mikefsq/scope_hub/mech/bottom_cover.step

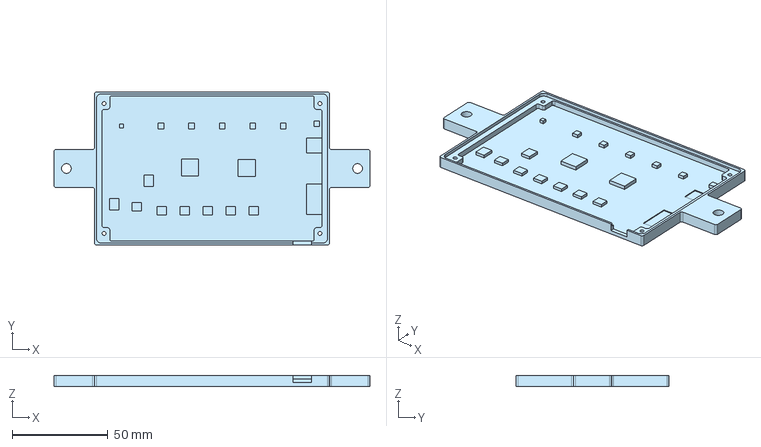
[picture p2: CAD file, 2026-11-07]
mech/bottom_cover.step
165.4 x 80.0 x 5.50 mm
