mikefsq/scope_hub/mech/top_cover.step

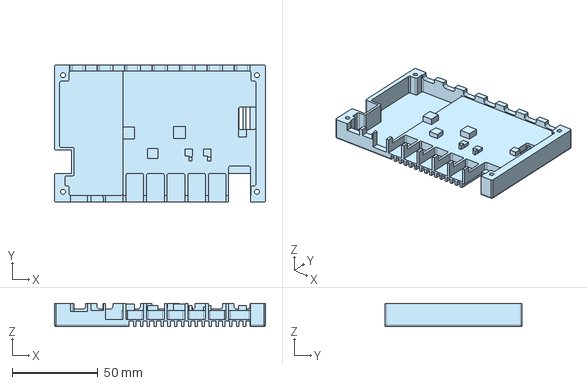
[picture p3: CAD file, 2026-11-01]
mech/top_cover.step
123.0 x 80.0 x 13.5 mm
