mikefsq/scope_hub/mech/ap_los_spacer_11mm.step

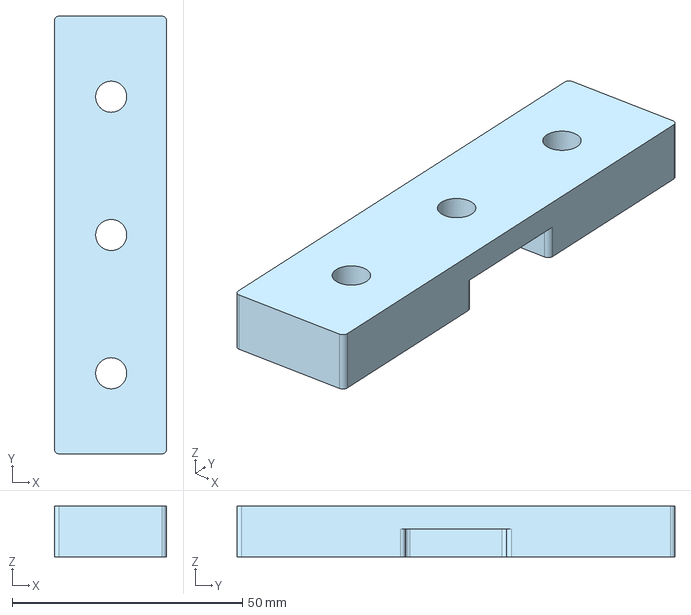
[picture p4: CAD file, 2026-11-01]
mech/ap_los_spacer_11mm.step
24.3 x 95.0 x 11.0 mm
