mikefsq/scope_hub/mech/primaluce_los_spacer_11mm.step

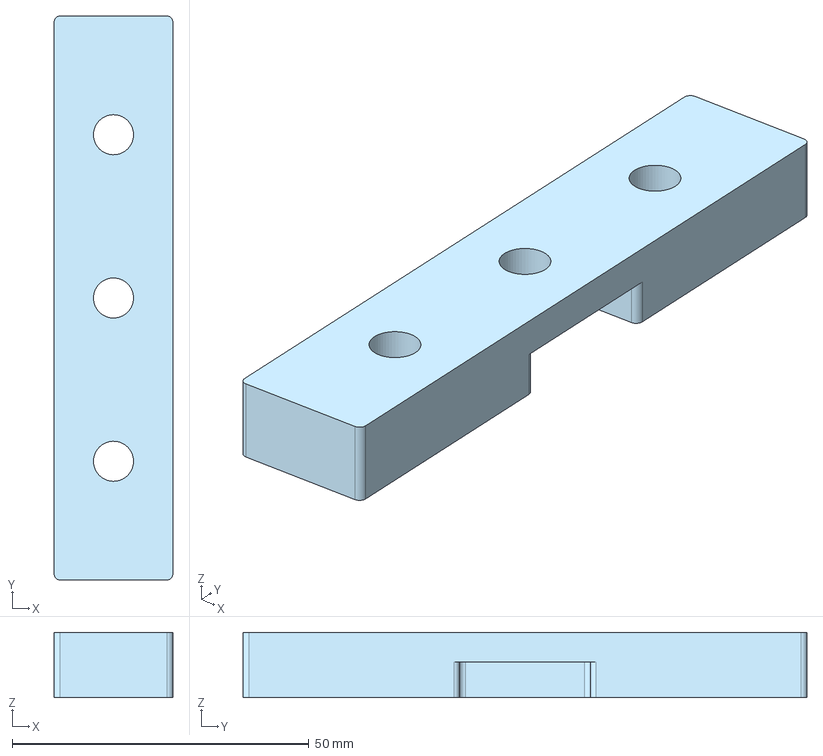
[picture p5: CAD file, 2026-11-01]
mech/primaluce_los_spacer_11mm.step
20.0 x 95.0 x 11.0 mm
