mikefsq/scope_hub/pcb/scope_hub.kicad_pcb

## KiCad design pcb/scope_hub.kicad_pcb (2026-10-31)

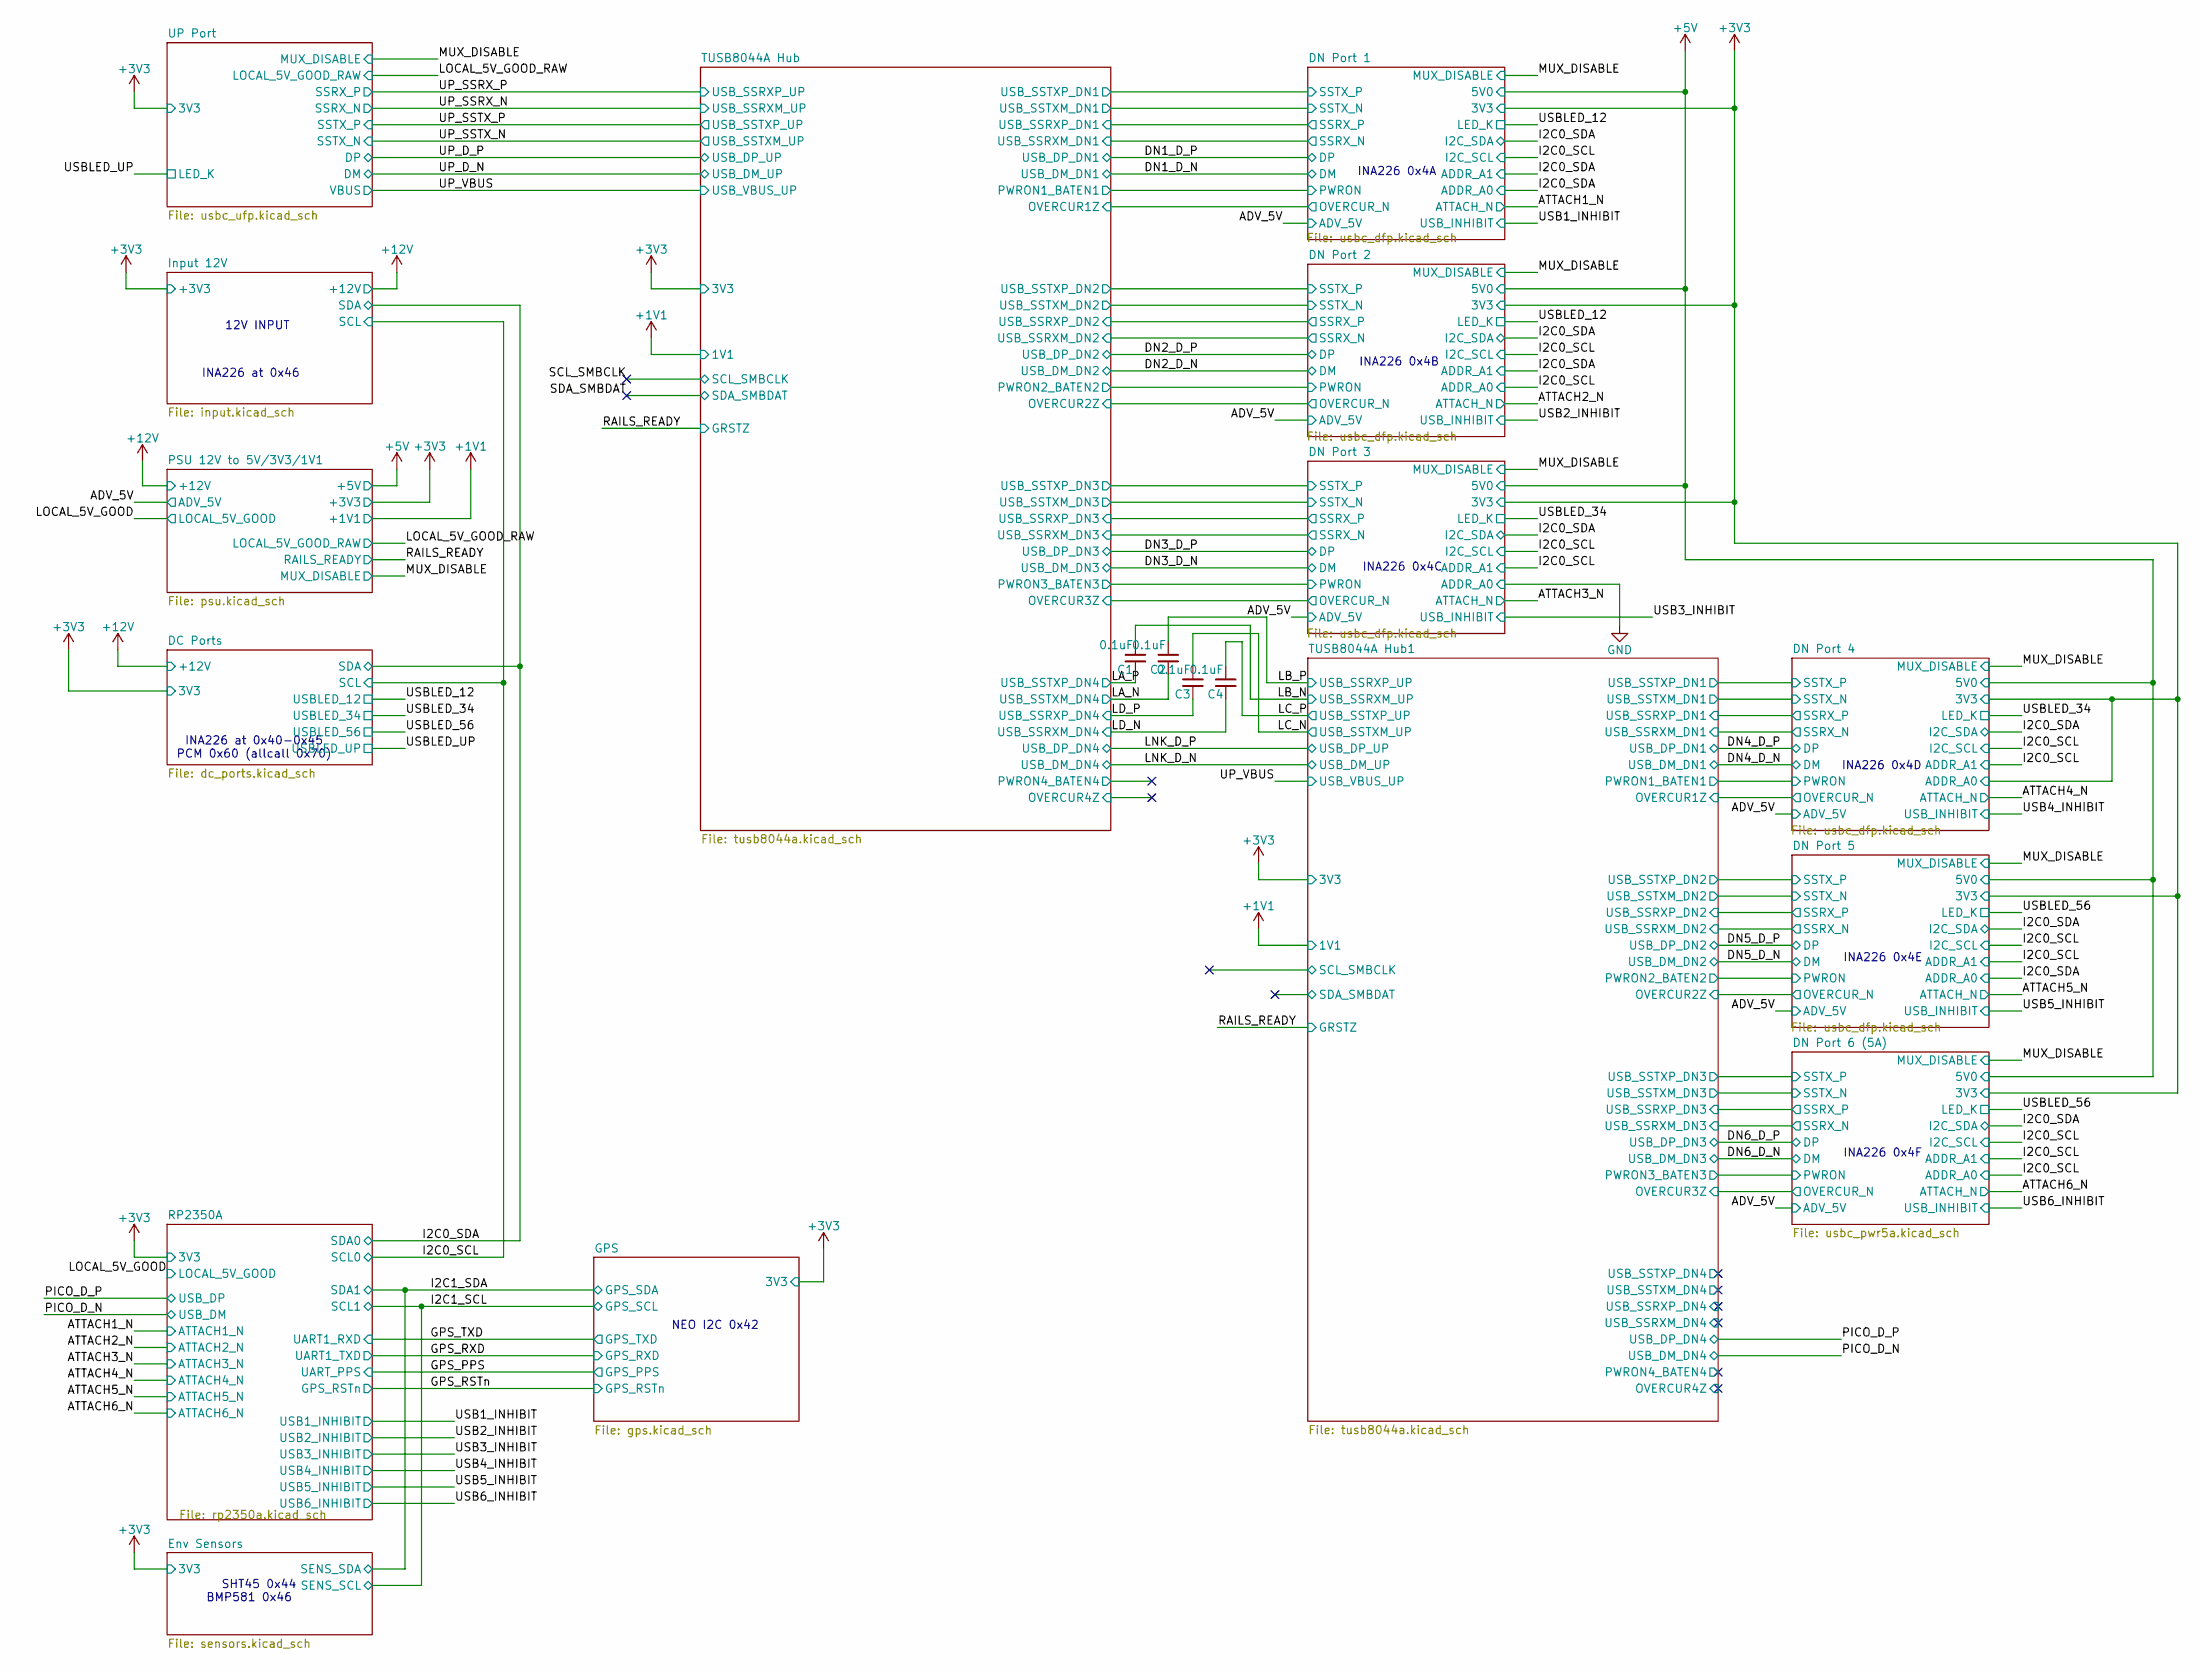
[picture p6: schematic scope_hub.kicad_sch]

Parts:
C1, C2, C3, C4: 0.1uF; C_0402_1005Metric; LCSC C1525

Connections:
/LA_N: C2.1; also elsewhere on the board
/LA_P: C1.1; also elsewhere on the board
/LB_N: C1.2; also elsewhere on the board
/LB_P: C2.2; also elsewhere on the board
/LC_N: C3.2; also elsewhere on the board
/LC_P: C4.2; also elsewhere on the board
/LD_N: C4.1; also elsewhere on the board
/LD_P: C3.1; also elsewhere on the board

Notes on the sheet:
12V INPUT
INA226 0x4C
INA226 at 0x40-0x45 PCM 0x60 (allcall 0x70)
INA226 0x4E
INA226 0x4B
INA226 0x4F
INA226 at 0x46
SHT45 0x44
BMP581 0x46
NEO I2C 0x42
INA226 0x4D
INA226 0x4A

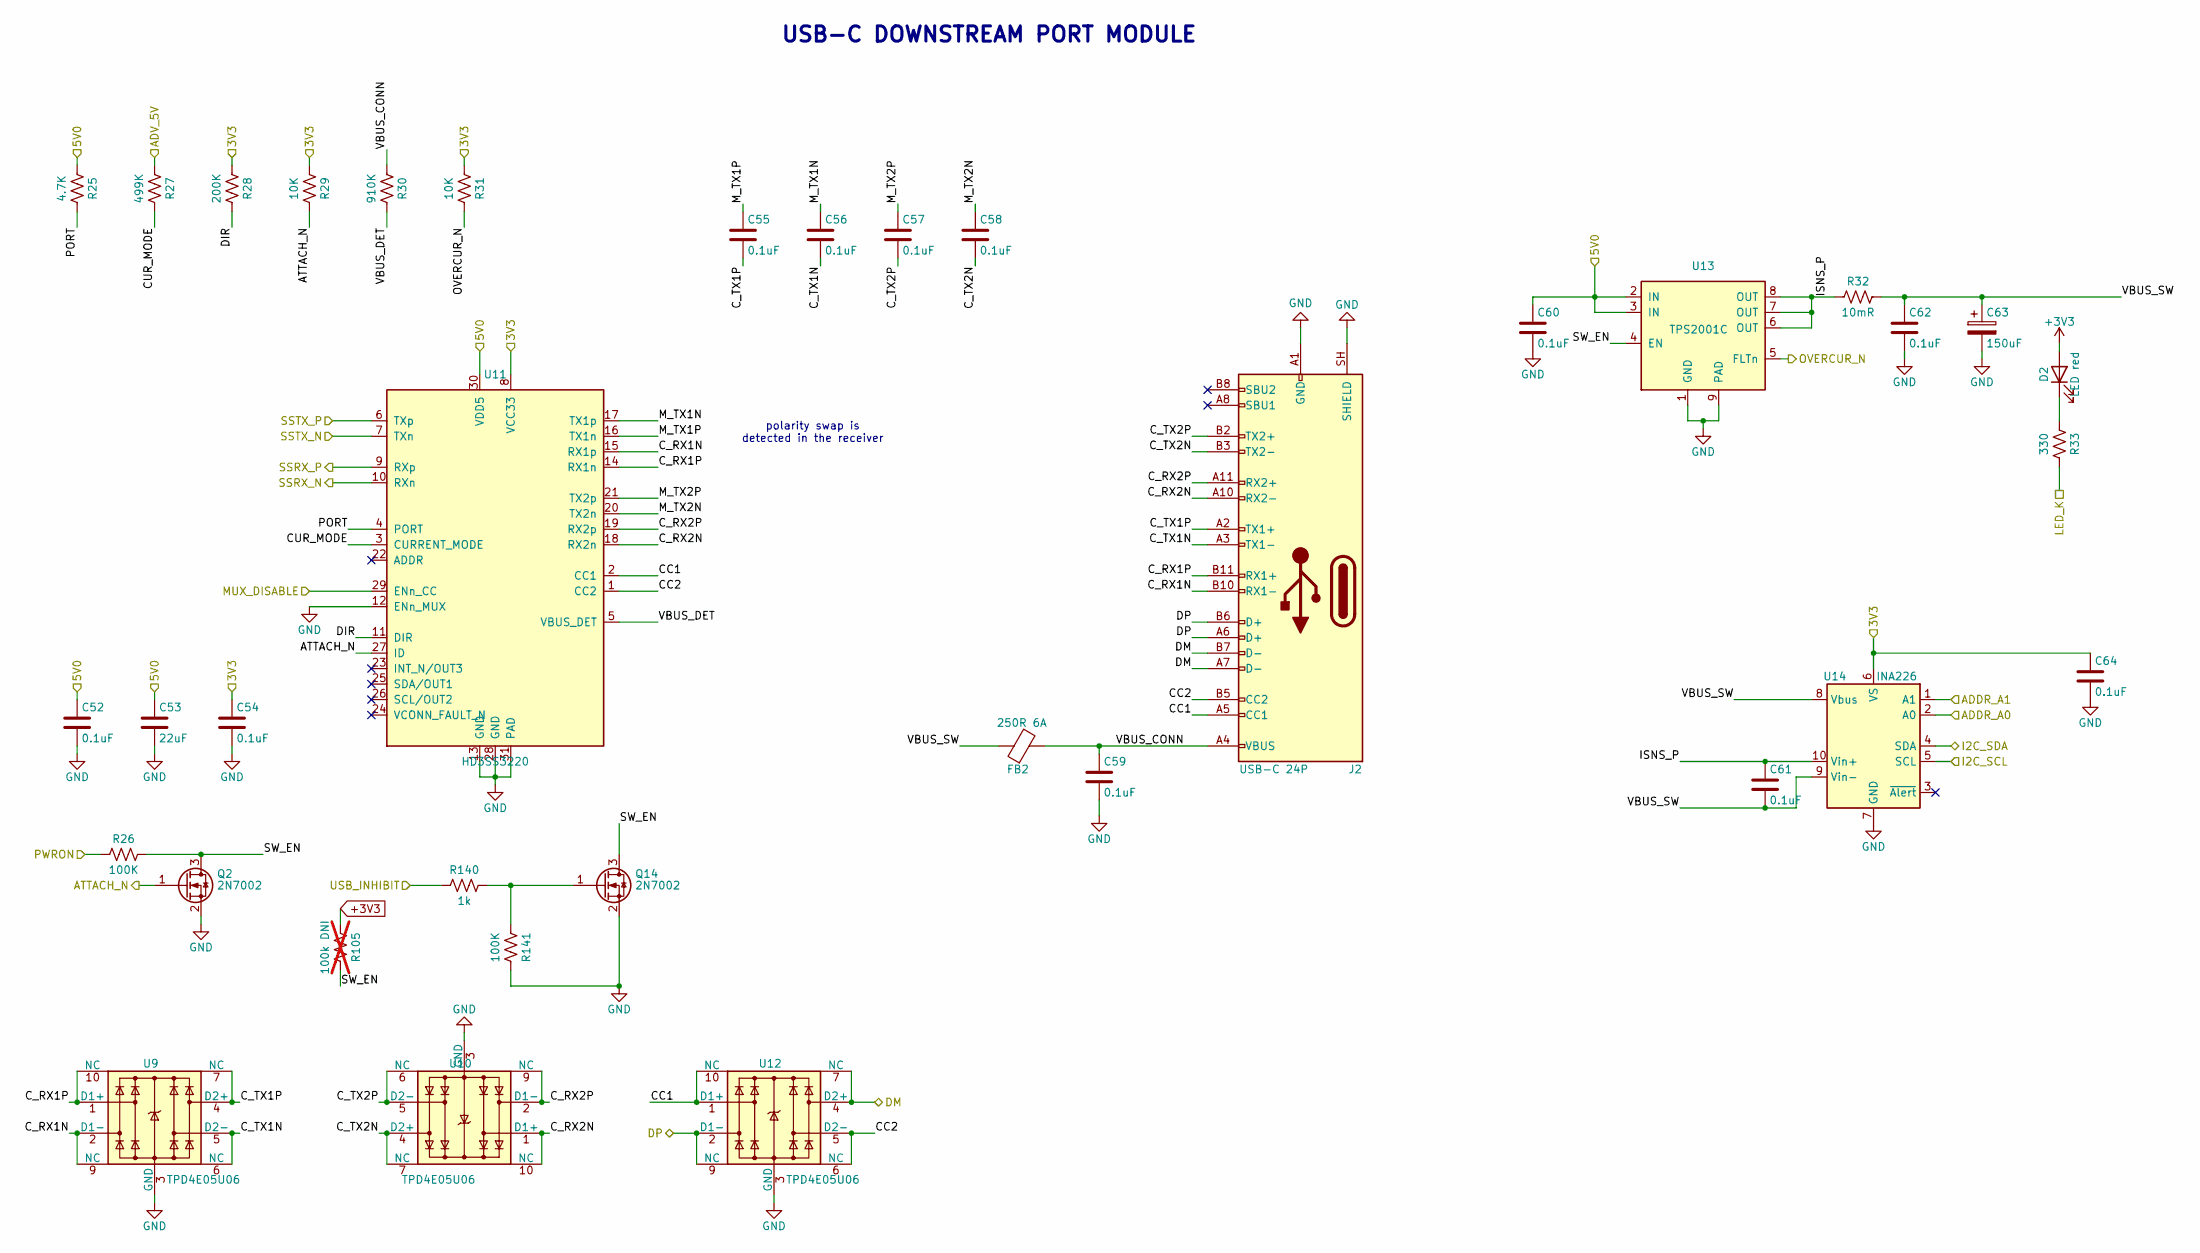
[picture p7: schematic usbc_dfp.kicad_sch]

Parts:
C52, C54, C55, C56, C57, C58, C59, C60, C61, C62, C64: 0.1uF; C_0402_1005Metric; LCSC C1525
C53: 22uF; C_0805_2012Metric; LCSC C45783
C63: 150uF; CP_EIA-3528-21_Kemet-B; LCSC C212682
D2: LED red; LED_0805_2012Metric; LCSC C84256
FB2: 250R 6A; FB_201210_PROD; MPN PSBHAA201210H-251T060; LCSC C48543401
J2: USB-C 24P; USB_C_Receptacle_Molex_105450-0101; MPN 105450-0101; LCSC C134092
Q2: 2N7002; SOT-23; LCSC C8545
Q14: 2N7002; SOT-23; MPN 2N7002; LCSC C8545
R25: 4.7K; R_0402_1005Metric; LCSC C25900
R26: 100K; R_0402_1005Metric; LCSC C25741
R27: 499K; R_0402_1005Metric; LCSC C25793
R28: 200K; R_0402_1005Metric; LCSC C25764
R29, R31: 10K; R_0402_1005Metric; LCSC C25744
R30: 910K; R_0402_1005Metric; LCSC C25800
R32: 10mR; R_1206_3216Metric; LCSC C105362
R33: 330; R_0402_1005Metric; LCSC C25104
R105: 100k DNI; R_0402_1005Metric; not fitted
R140: 1k; R_0402_1005Metric; MPN 0402WGF1001TCE; LCSC C11702
R141: 100K; R_0402_1005Metric; MPN 0402WGF1003TCE; LCSC C25741
U9, U10, U12: TPD4E05U06; USON-10_2.5x1.0mm_P0.5mm; LCSC C138714
U11: HD3SS3220; Texas_RNH0030A_WQFN-30-1EP_2.5x4.5mm_P0.4mm_EP1.2x3.2mm; LCSC C165155
U13: TPS2001C; MSOP-8-1EP_3x3mm_P0.65mm_EP1.68x1.88mm; LCSC C473349
U14: INA226; TSSOP-10_3x3mm_P0.5mm; LCSC C49851

Connections:
+3V3: C54.1, C64.1, D2.2 (A), R28.1, R29.1, R31.1, R105.1, U11.8 (VCC33), U14.6 (VS); also elsewhere on the board
+5V: C52.1, C53.1, C60.1, R25.1, U11.30 (VDD5), U13.2 (IN), U13.3 (IN); also elsewhere on the board
/ADV_5V: R27.1; also elsewhere on the board
/ATTACH2_N: Q2.1 (G), R29.2, U11.27 (ID); also elsewhere on the board
/DN2_D_N: J2.A7 (D-), J2.B7 (D-), U12.4 (D2+), U12.7 (NC); also elsewhere on the board
/DN2_D_P: J2.A6 (D+), J2.B6 (D+), U12.2 (D1-), U12.9 (NC); also elsewhere on the board
/DN Port 2/CC1: J2.A5 (CC1), U11.2 (CC1), U12.1 (D1+), U12.10 (NC)
/DN Port 2/CC2: J2.B5 (CC2), U11.1 (CC2), U12.5 (D2-), U12.6 (NC)
/DN Port 2/CUR_MODE: R27.2, U11.3 (CURRENT_MODE)
/DN Port 2/C_RX1N: J2.B10 (RX1-), U9.2 (D1-), U9.9 (NC), U11.15 (RX1p)
/DN Port 2/C_RX1P: J2.B11 (RX1+), U9.1 (D1+), U9.10 (NC), U11.14 (RX1n)
/DN Port 2/C_RX2N: J2.A10 (RX2-), U10.1 (D1+), U10.10 (NC), U11.18 (RX2n)
/DN Port 2/C_RX2P: J2.A11 (RX2+), U10.2 (D1-), U10.9 (NC), U11.19 (RX2p)
/DN Port 2/C_TX1N: C56.2, J2.A3 (TX1-), U9.5 (D2-), U9.6 (NC)
/DN Port 2/C_TX1P: C55.2, J2.A2 (TX1+), U9.4 (D2+), U9.7 (NC)
/DN Port 2/C_TX2N: C58.2, J2.B3 (TX2-), U10.4 (D2+), U10.7 (NC)
/DN Port 2/C_TX2P: C57.2, J2.B2 (TX2+), U10.5 (D2-), U10.6 (NC)
/DN Port 2/DIR: R28.2, U11.11 (DIR)
/DN Port 2/ISNS_P: C61.1, R32.1, U13.6 (OUT), U13.7 (OUT), U13.8 (OUT), U14.10 (Vin+)
/DN Port 2/M_TX1N: C56.1, U11.17 (TX1p)
/DN Port 2/M_TX1P: C55.1, U11.16 (TX1n)
/DN Port 2/M_TX2N: C58.1, U11.20 (TX2n)
/DN Port 2/M_TX2P: C57.1, U11.21 (TX2p)
/DN Port 2/OVERCUR_N: R31.2, U13.5 (FLTn); also elsewhere on the board
/DN Port 2/PORT: R25.2, U11.4 (PORT)
/DN Port 2/SSRX_N: U11.10 (RXn); also elsewhere on the board
/DN Port 2/SSRX_P: U11.9 (RXp); also elsewhere on the board
/DN Port 2/SSTX_N: U11.7 (TXn); also elsewhere on the board
/DN Port 2/SSTX_P: U11.6 (TXp); also elsewhere on the board
/DN Port 2/SW_EN: Q2.3 (D), Q14.3 (D), R26.2, R105.2, U13.4 (EN)
/DN Port 2/VBUS_CONN: C59.1, FB2.2, J2.A4 (VBUS), J2.A9 (VBUS), J2.B4 (VBUS), J2.B9 (VBUS), R30.1
/DN Port 2/VBUS_DET: R30.2, U11.5 (VBUS_DET)
/DN Port 2/VBUS_SW: C61.2, C62.1, C63.1, FB2.1, R32.2, U14.8 (Vbus), U14.9 (Vin-)
/I2C0_SCL: U14.2 (A0), U14.5 (SCL); also elsewhere on the board
/I2C0_SDA: U14.1 (A1), U14.4 (SDA); also elsewhere on the board
/MUX_DISABLE: U11.29 (ENn_CC); also elsewhere on the board
/TUSB8044A Hub/PWRON2_BATEN2: R26.1; also elsewhere on the board
/USB2_INHIBIT: R140.1; also elsewhere on the board
/USBLED_12: R33.2; also elsewhere on the board
GND: C52.2, C53.2, C54.2, C59.2, C60.2, C62.2, C63.2, C64.2, J2.A1 (GND), J2.A12 (GND), J2.B1 (GND), J2.B12 (GND), J2.SH (SHIELD), Q2.2 (S), Q14.2 (S), R141.2, U9.3 (GND), U9.8 (GND), U10.3 (GND), U10.8 (GND), U11.12 (ENn_MUX), U11.13 (GND), U11.28 (GND), U11.31 (PAD), U12.3 (GND), U12.8 (GND), U13.1 (GND), U13.9 (PAD), U14.7 (GND); also elsewhere on the board
unnamed: D2.1 (K), R33.1
unnamed: Q14.1 (G), R140.2, R141.1

Parts of its further copies:
C39, C41, C42, C43, C44, C45, C46, C47, C48, C49, C51, C65, C67, C68, C69, C70, C71, C72, C73, C74, C75, C77, C120, C122, C123, C124, C125, C126, C127, C128, C129, C130, C132, C133, C135, C136, C137, C138, C139, C140, C141, C142, C143, C145: 0.1uF; C_0402_1005Metric; LCSC C1525
C40, C66, C121, C134: 22uF; C_0805_2012Metric; LCSC C45783
C50, C76, C131, C144: 150uF; CP_EIA-3528-21_Kemet-B; LCSC C212682
D1, D3, D5, D6: LED red; LED_0805_2012Metric; LCSC C84256
FB1, FB3, FB5, FB6: 250R 6A; FB_201210_PROD; MPN PSBHAA201210H-251T060; LCSC C48543401
J1, J3, J5, J6: USB-C 24P; USB_C_Receptacle_Molex_105450-0101; MPN 105450-0101; LCSC C134092
Q1, Q3, Q4, Q5: 2N7002; SOT-23; LCSC C8545
Q8, Q9, Q10, Q11: 2N7002; SOT-23; MPN 2N7002; LCSC C8545
R16, R34, R62, R71: 4.7K; R_0402_1005Metric; LCSC C25900
R17, R35, R63, R72: 100K; R_0402_1005Metric; LCSC C25741
R18, R36, R64, R73: 499K; R_0402_1005Metric; LCSC C25793
R19, R37, R65, R74: 200K; R_0402_1005Metric; LCSC C25764
R20, R22, R38, R40, R66, R68, R75, R77: 10K; R_0402_1005Metric; LCSC C25744
R21, R39, R67, R76: 910K; R_0402_1005Metric; LCSC C25800
R23, R41, R69, R78: 10mR; R_1206_3216Metric; LCSC C105362
R24, R42, R70, R79: 330; R_0402_1005Metric; LCSC C25104
R142, R144, R146, R148: 1k; R_0402_1005Metric; MPN 0402WGF1001TCE; LCSC C11702
R143, R145, R147, R149: 100K; R_0402_1005Metric; MPN 0402WGF1003TCE; LCSC C25741
R167, R168, R169, R170: 100k DNI; R_0402_1005Metric; not fitted
U3, U4, U6, U15, U16, U18, U28, U29, U31, U34, U35, U37: TPD4E05U06; USON-10_2.5x1.0mm_P0.5mm; LCSC C138714
U5, U17, U30, U36: HD3SS3220; Texas_RNH0030A_WQFN-30-1EP_2.5x4.5mm_P0.4mm_EP1.2x3.2mm; LCSC C165155
U7, U19, U32, U38: TPS2001C; MSOP-8-1EP_3x3mm_P0.65mm_EP1.68x1.88mm; LCSC C473349
U8, U20, U33, U39: INA226; TSSOP-10_3x3mm_P0.5mm; LCSC C49851

Connections of its further copies:
+3V3: C41.1, C51.1, C67.1, C77.1, C122.1, C132.1, C135.1, C145.1, D1.2 (A), D3.2 (A), D5.2 (A), D6.2 (A), R19.1, R20.1, R22.1, R37.1, R38.1, R40.1, R65.1, R66.1, R68.1, R74.1, R75.1, R77.1, R167.1, R168.1, R169.1, R170.1, U5.8 (VCC33), U8.6 (VS), U17.8 (VCC33), U20.6 (VS), U30.8 (VCC33), U33.2 (A0), U33.6 (VS), U36.8 (VCC33), U39.6 (VS); also elsewhere on the board
+5V: C39.1, C40.1, C47.1, C65.1, C66.1, C73.1, C120.1, C121.1, C128.1, C133.1, C134.1, C141.1, R16.1, R34.1, R62.1, R71.1, U5.30 (VDD5), U7.2 (IN), U7.3 (IN), U17.30 (VDD5), U19.2 (IN), U19.3 (IN), U30.30 (VDD5), U32.2 (IN), U32.3 (IN), U36.30 (VDD5), U38.2 (IN), U38.3 (IN); also elsewhere on the board
/ADV_5V: R18.1, R36.1, R64.1, R73.1; also elsewhere on the board
/ATTACH1_N: Q1.1 (G), R20.2, U5.27 (ID); also elsewhere on the board
/ATTACH3_N: Q3.1 (G), R38.2, U17.27 (ID); also elsewhere on the board
/ATTACH4_N: Q4.1 (G), R66.2, U30.27 (ID); also elsewhere on the board
/ATTACH5_N: Q5.1 (G), R75.2, U36.27 (ID); also elsewhere on the board
/DN1_D_N: J1.A7 (D-), J1.B7 (D-), U6.4 (D2+), U6.7 (NC); also elsewhere on the board
/DN1_D_P: J1.A6 (D+), J1.B6 (D+), U6.2 (D1-), U6.9 (NC); also elsewhere on the board
/DN3_D_N: J3.A7 (D-), J3.B7 (D-), U18.4 (D2+), U18.7 (NC); also elsewhere on the board
/DN3_D_P: J3.A6 (D+), J3.B6 (D+), U18.2 (D1-), U18.9 (NC); also elsewhere on the board
/DN4_D_N: J5.A7 (D-), J5.B7 (D-), U31.4 (D2+), U31.7 (NC); also elsewhere on the board
/DN4_D_P: J5.A6 (D+), J5.B6 (D+), U31.2 (D1-), U31.9 (NC); also elsewhere on the board
/DN5_D_N: J6.A7 (D-), J6.B7 (D-), U37.4 (D2+), U37.7 (NC); also elsewhere on the board
/DN5_D_P: J6.A6 (D+), J6.B6 (D+), U37.2 (D1-), U37.9 (NC); also elsewhere on the board
/DN Port 1/CC1: J1.A5 (CC1), U5.2 (CC1), U6.1 (D1+), U6.10 (NC)
/DN Port 1/CC2: J1.B5 (CC2), U5.1 (CC2), U6.5 (D2-), U6.6 (NC)
/DN Port 1/CUR_MODE: R18.2, U5.3 (CURRENT_MODE)
/DN Port 1/C_RX1N: J1.B10 (RX1-), U3.2 (D1-), U3.9 (NC), U5.15 (RX1p)
/DN Port 1/C_RX1P: J1.B11 (RX1+), U3.1 (D1+), U3.10 (NC), U5.14 (RX1n)
/DN Port 1/C_RX2N: J1.A10 (RX2-), U4.1 (D1+), U4.10 (NC), U5.18 (RX2n)
/DN Port 1/C_RX2P: J1.A11 (RX2+), U4.2 (D1-), U4.9 (NC), U5.19 (RX2p)
/DN Port 1/C_TX1N: C43.2, J1.A3 (TX1-), U3.5 (D2-), U3.6 (NC)
/DN Port 1/C_TX1P: C42.2, J1.A2 (TX1+), U3.4 (D2+), U3.7 (NC)
/DN Port 1/C_TX2N: C45.2, J1.B3 (TX2-), U4.4 (D2+), U4.7 (NC)
/DN Port 1/C_TX2P: C44.2, J1.B2 (TX2+), U4.5 (D2-), U4.6 (NC)
/DN Port 1/DIR: R19.2, U5.11 (DIR)
/DN Port 1/ISNS_P: C48.1, R23.1, U7.6 (OUT), U7.7 (OUT), U7.8 (OUT), U8.10 (Vin+)
/DN Port 1/M_TX1N: C43.1, U5.17 (TX1p)
/DN Port 1/M_TX1P: C42.1, U5.16 (TX1n)
/DN Port 1/M_TX2N: C45.1, U5.20 (TX2n)
/DN Port 1/M_TX2P: C44.1, U5.21 (TX2p)
/DN Port 1/OVERCUR_N: R22.2, U7.5 (FLTn); also elsewhere on the board
/DN Port 1/PORT: R16.2, U5.4 (PORT)
/DN Port 1/SSRX_N: U5.10 (RXn); also elsewhere on the board
/DN Port 1/SSRX_P: U5.9 (RXp); also elsewhere on the board
/DN Port 1/SSTX_N: U5.7 (TXn); also elsewhere on the board
/DN Port 1/SSTX_P: U5.6 (TXp); also elsewhere on the board
/DN Port 1/SW_EN: Q1.3 (D), Q10.3 (D), R17.2, R169.2, U7.4 (EN)
/DN Port 1/VBUS_CONN: C46.1, FB1.2, J1.A4 (VBUS), J1.A9 (VBUS), J1.B4 (VBUS), J1.B9 (VBUS), R21.1
/DN Port 1/VBUS_DET: R21.2, U5.5 (VBUS_DET)
/DN Port 1/VBUS_SW: C48.2, C49.1, C50.1, FB1.1, R23.2, U8.8 (Vbus), U8.9 (Vin-)
/DN Port 3/CC1: J3.A5 (CC1), U17.2 (CC1), U18.1 (D1+), U18.10 (NC)
/DN Port 3/CC2: J3.B5 (CC2), U17.1 (CC2), U18.5 (D2-), U18.6 (NC)
/DN Port 3/CUR_MODE: R36.2, U17.3 (CURRENT_MODE)
/DN Port 3/C_RX1N: J3.B10 (RX1-), U15.2 (D1-), U15.9 (NC), U17.15 (RX1p)
/DN Port 3/C_RX1P: J3.B11 (RX1+), U15.1 (D1+), U15.10 (NC), U17.14 (RX1n)
/DN Port 3/C_RX2N: J3.A10 (RX2-), U16.1 (D1+), U16.10 (NC), U17.18 (RX2n)
/DN Port 3/C_RX2P: J3.A11 (RX2+), U16.2 (D1-), U16.9 (NC), U17.19 (RX2p)
/DN Port 3/C_TX1N: C69.2, J3.A3 (TX1-), U15.5 (D2-), U15.6 (NC)
/DN Port 3/C_TX1P: C68.2, J3.A2 (TX1+), U15.4 (D2+), U15.7 (NC)
/DN Port 3/C_TX2N: C71.2, J3.B3 (TX2-), U16.4 (D2+), U16.7 (NC)
/DN Port 3/C_TX2P: C70.2, J3.B2 (TX2+), U16.5 (D2-), U16.6 (NC)
/DN Port 3/DIR: R37.2, U17.11 (DIR)
/DN Port 3/ISNS_P: C74.1, R41.1, U19.6 (OUT), U19.7 (OUT), U19.8 (OUT), U20.10 (Vin+)
/DN Port 3/M_TX1N: C69.1, U17.17 (TX1p)
/DN Port 3/M_TX1P: C68.1, U17.16 (TX1n)
/DN Port 3/M_TX2N: C71.1, U17.20 (TX2n)
/DN Port 3/M_TX2P: C70.1, U17.21 (TX2p)
/DN Port 3/OVERCUR_N: R40.2, U19.5 (FLTn); also elsewhere on the board
/DN Port 3/PORT: R34.2, U17.4 (PORT)
/DN Port 3/SSRX_N: U17.10 (RXn); also elsewhere on the board
/DN Port 3/SSRX_P: U17.9 (RXp); also elsewhere on the board
/DN Port 3/SSTX_N: U17.7 (TXn); also elsewhere on the board
/DN Port 3/SSTX_P: U17.6 (TXp); also elsewhere on the board
/DN Port 3/SW_EN: Q3.3 (D), Q8.3 (D), R35.2, R167.2, U19.4 (EN)
/DN Port 3/VBUS_CONN: C72.1, FB3.2, J3.A4 (VBUS), J3.A9 (VBUS), J3.B4 (VBUS), J3.B9 (VBUS), R39.1
/DN Port 3/VBUS_DET: R39.2, U17.5 (VBUS_DET)
/DN Port 3/VBUS_SW: C74.2, C75.1, C76.1, FB3.1, R41.2, U20.8 (Vbus), U20.9 (Vin-)
/DN Port 4/CC1: J5.A5 (CC1), U30.2 (CC1), U31.1 (D1+), U31.10 (NC)
/DN Port 4/CC2: J5.B5 (CC2), U30.1 (CC2), U31.5 (D2-), U31.6 (NC)
/DN Port 4/CUR_MODE: R64.2, U30.3 (CURRENT_MODE)
/DN Port 4/C_RX1N: J5.B10 (RX1-), U28.2 (D1-), U28.9 (NC), U30.15 (RX1p)
/DN Port 4/C_RX1P: J5.B11 (RX1+), U28.1 (D1+), U28.10 (NC), U30.14 (RX1n)
/DN Port 4/C_RX2N: J5.A10 (RX2-), U29.1 (D1+), U29.10 (NC), U30.18 (RX2n)
/DN Port 4/C_RX2P: J5.A11 (RX2+), U29.2 (D1-), U29.9 (NC), U30.19 (RX2p)
/DN Port 4/C_TX1N: C124.2, J5.A3 (TX1-), U28.5 (D2-), U28.6 (NC)
/DN Port 4/C_TX1P: C123.2, J5.A2 (TX1+), U28.4 (D2+), U28.7 (NC)
/DN Port 4/C_TX2N: C126.2, J5.B3 (TX2-), U29.4 (D2+), U29.7 (NC)
/DN Port 4/C_TX2P: C125.2, J5.B2 (TX2+), U29.5 (D2-), U29.6 (NC)
/DN Port 4/DIR: R65.2, U30.11 (DIR)
/DN Port 4/ISNS_P: C129.1, R69.1, U32.6 (OUT), U32.7 (OUT), U32.8 (OUT), U33.10 (Vin+)
/DN Port 4/M_TX1N: C124.1, U30.17 (TX1p)
/DN Port 4/M_TX1P: C123.1, U30.16 (TX1n)
/DN Port 4/M_TX2N: C126.1, U30.20 (TX2n)
/DN Port 4/M_TX2P: C125.1, U30.21 (TX2p)
/DN Port 4/OVERCUR_N: R68.2, U32.5 (FLTn); also elsewhere on the board
/DN Port 4/PORT: R62.2, U30.4 (PORT)
/DN Port 4/SSRX_N: U30.10 (RXn); also elsewhere on the board
/DN Port 4/SSRX_P: U30.9 (RXp); also elsewhere on the board
/DN Port 4/SSTX_N: U30.7 (TXn); also elsewhere on the board
/DN Port 4/SSTX_P: U30.6 (TXp); also elsewhere on the board
/DN Port 4/SW_EN: Q4.3 (D), Q9.3 (D), R63.2, R168.2, U32.4 (EN)
/DN Port 4/VBUS_CONN: C127.1, FB5.2, J5.A4 (VBUS), J5.A9 (VBUS), J5.B4 (VBUS), J5.B9 (VBUS), R67.1
/DN Port 4/VBUS_DET: R67.2, U30.5 (VBUS_DET)
/DN Port 4/VBUS_SW: C129.2, C130.1, C131.1, FB5.1, R69.2, U33.8 (Vbus), U33.9 (Vin-)
/DN Port 5/CC1: J6.A5 (CC1), U36.2 (CC1), U37.1 (D1+), U37.10 (NC)
/DN Port 5/CC2: J6.B5 (CC2), U36.1 (CC2), U37.5 (D2-), U37.6 (NC)
/DN Port 5/CUR_MODE: R73.2, U36.3 (CURRENT_MODE)
/DN Port 5/C_RX1N: J6.B10 (RX1-), U34.2 (D1-), U34.9 (NC), U36.15 (RX1p)
/DN Port 5/C_RX1P: J6.B11 (RX1+), U34.1 (D1+), U34.10 (NC), U36.14 (RX1n)
/DN Port 5/C_RX2N: J6.A10 (RX2-), U35.1 (D1+), U35.10 (NC), U36.18 (RX2n)
/DN Port 5/C_RX2P: J6.A11 (RX2+), U35.2 (D1-), U35.9 (NC), U36.19 (RX2p)
/DN Port 5/C_TX1N: C137.2, J6.A3 (TX1-), U34.5 (D2-), U34.6 (NC)
/DN Port 5/C_TX1P: C136.2, J6.A2 (TX1+), U34.4 (D2+), U34.7 (NC)
/DN Port 5/C_TX2N: C139.2, J6.B3 (TX2-), U35.4 (D2+), U35.7 (NC)
/DN Port 5/C_TX2P: C138.2, J6.B2 (TX2+), U35.5 (D2-), U35.6 (NC)
/DN Port 5/DIR: R74.2, U36.11 (DIR)
/DN Port 5/ISNS_P: C142.1, R78.1, U38.6 (OUT), U38.7 (OUT), U38.8 (OUT), U39.10 (Vin+)
/DN Port 5/M_TX1N: C137.1, U36.17 (TX1p)
/DN Port 5/M_TX1P: C136.1, U36.16 (TX1n)
/DN Port 5/M_TX2N: C139.1, U36.20 (TX2n)
/DN Port 5/M_TX2P: C138.1, U36.21 (TX2p)
/DN Port 5/OVERCUR_N: R77.2, U38.5 (FLTn); also elsewhere on the board
/DN Port 5/PORT: R71.2, U36.4 (PORT)
/DN Port 5/SSRX_N: U36.10 (RXn); also elsewhere on the board
/DN Port 5/SSRX_P: U36.9 (RXp); also elsewhere on the board
/DN Port 5/SSTX_N: U36.7 (TXn); also elsewhere on the board
/DN Port 5/SSTX_P: U36.6 (TXp); also elsewhere on the board
/DN Port 5/SW_EN: Q5.3 (D), Q11.3 (D), R72.2, R170.2, U38.4 (EN)
/DN Port 5/VBUS_CONN: C140.1, FB6.2, J6.A4 (VBUS), J6.A9 (VBUS), J6.B4 (VBUS), J6.B9 (VBUS), R76.1
/DN Port 5/VBUS_DET: R76.2, U36.5 (VBUS_DET)
/DN Port 5/VBUS_SW: C142.2, C143.1, C144.1, FB6.1, R78.2, U39.8 (Vbus), U39.9 (Vin-)
/I2C0_SCL: U8.5 (SCL), U20.1 (A1), U20.5 (SCL), U33.1 (A1), U33.5 (SCL), U39.1 (A1), U39.5 (SCL); also elsewhere on the board
/I2C0_SDA: U8.1 (A1), U8.2 (A0), U8.4 (SDA), U20.4 (SDA), U33.4 (SDA), U39.2 (A0), U39.4 (SDA); also elsewhere on the board
/MUX_DISABLE: U5.29 (ENn_CC), U17.29 (ENn_CC), U30.29 (ENn_CC), U36.29 (ENn_CC); also elsewhere on the board
/TUSB8044A Hub1/PWRON1_BATEN1: R63.1; also elsewhere on the board
/TUSB8044A Hub1/PWRON2_BATEN2: R72.1; also elsewhere on the board
/TUSB8044A Hub/PWRON1_BATEN1: R17.1; also elsewhere on the board
/TUSB8044A Hub/PWRON3_BATEN3: R35.1; also elsewhere on the board
/USB1_INHIBIT: R146.1; also elsewhere on the board
/USB3_INHIBIT: R142.1; also elsewhere on the board
/USB4_INHIBIT: R144.1; also elsewhere on the board
/USB5_INHIBIT: R148.1; also elsewhere on the board
/USBLED_12: R24.2; also elsewhere on the board
/USBLED_34: R42.2, R70.2; also elsewhere on the board
/USBLED_56: R79.2; also elsewhere on the board
GND: C39.2, C40.2, C41.2, C46.2, C47.2, C49.2, C50.2, C51.2, C65.2, C66.2, C67.2, C72.2, C73.2, C75.2, C76.2, C77.2, C120.2, C121.2, C122.2, C127.2, C128.2, C130.2, C131.2, C132.2, C133.2, C134.2, C135.2, C140.2, C141.2, C143.2, C144.2, C145.2, J1.A1 (GND), J1.A12 (GND), J1.B1 (GND), J1.B12 (GND), J1.SH (SHIELD), J3.A1 (GND), J3.A12 (GND), J3.B1 (GND), J3.B12 (GND), J3.SH (SHIELD), J5.A1 (GND), J5.A12 (GND), J5.B1 (GND), J5.B12 (GND), J5.SH (SHIELD), J6.A1 (GND), J6.A12 (GND), J6.B1 (GND), J6.B12 (GND), J6.SH (SHIELD), Q1.2 (S), Q3.2 (S), Q4.2 (S), Q5.2 (S), Q8.2 (S), Q9.2 (S), Q10.2 (S), Q11.2 (S), R143.2, R145.2, R147.2, R149.2, U3.3 (GND), U3.8 (GND), U4.3 (GND), U4.8 (GND), U5.12 (ENn_MUX), U5.13 (GND), U5.28 (GND), U5.31 (PAD), U6.3 (GND), U6.8 (GND), U7.1 (GND), U7.9 (PAD), U8.7 (GND), U15.3 (GND), U15.8 (GND), U16.3 (GND), U16.8 (GND), U17.12 (ENn_MUX), U17.13 (GND), U17.28 (GND), U17.31 (PAD), U18.3 (GND), U18.8 (GND), U19.1 (GND), U19.9 (PAD), U20.2 (A0), U20.7 (GND), U28.3 (GND), U28.8 (GND), U29.3 (GND), U29.8 (GND), U30.12 (ENn_MUX), U30.13 (GND), U30.28 (GND), U30.31 (PAD), U31.3 (GND), U31.8 (GND), U32.1 (GND), U32.9 (PAD), U33.7 (GND), U34.3 (GND), U34.8 (GND), U35.3 (GND), U35.8 (GND), U36.12 (ENn_MUX), U36.13 (GND), U36.28 (GND), U36.31 (PAD), U37.3 (GND), U37.8 (GND), U38.1 (GND), U38.9 (PAD), U39.7 (GND); also elsewhere on the board
unnamed: D1.1 (K), R24.1
unnamed: D3.1 (K), R42.1
unnamed: D5.1 (K), R70.1
unnamed: D6.1 (K), R79.1
unnamed: Q8.1 (G), R142.2, R143.1
unnamed: Q9.1 (G), R144.2, R145.1
unnamed: Q10.1 (G), R146.2, R147.1
unnamed: Q11.1 (G), R148.2, R149.1

Notes on the sheet:
USB-C DOWNSTREAM PORT MODULE
polarity swap is detected in the receiver

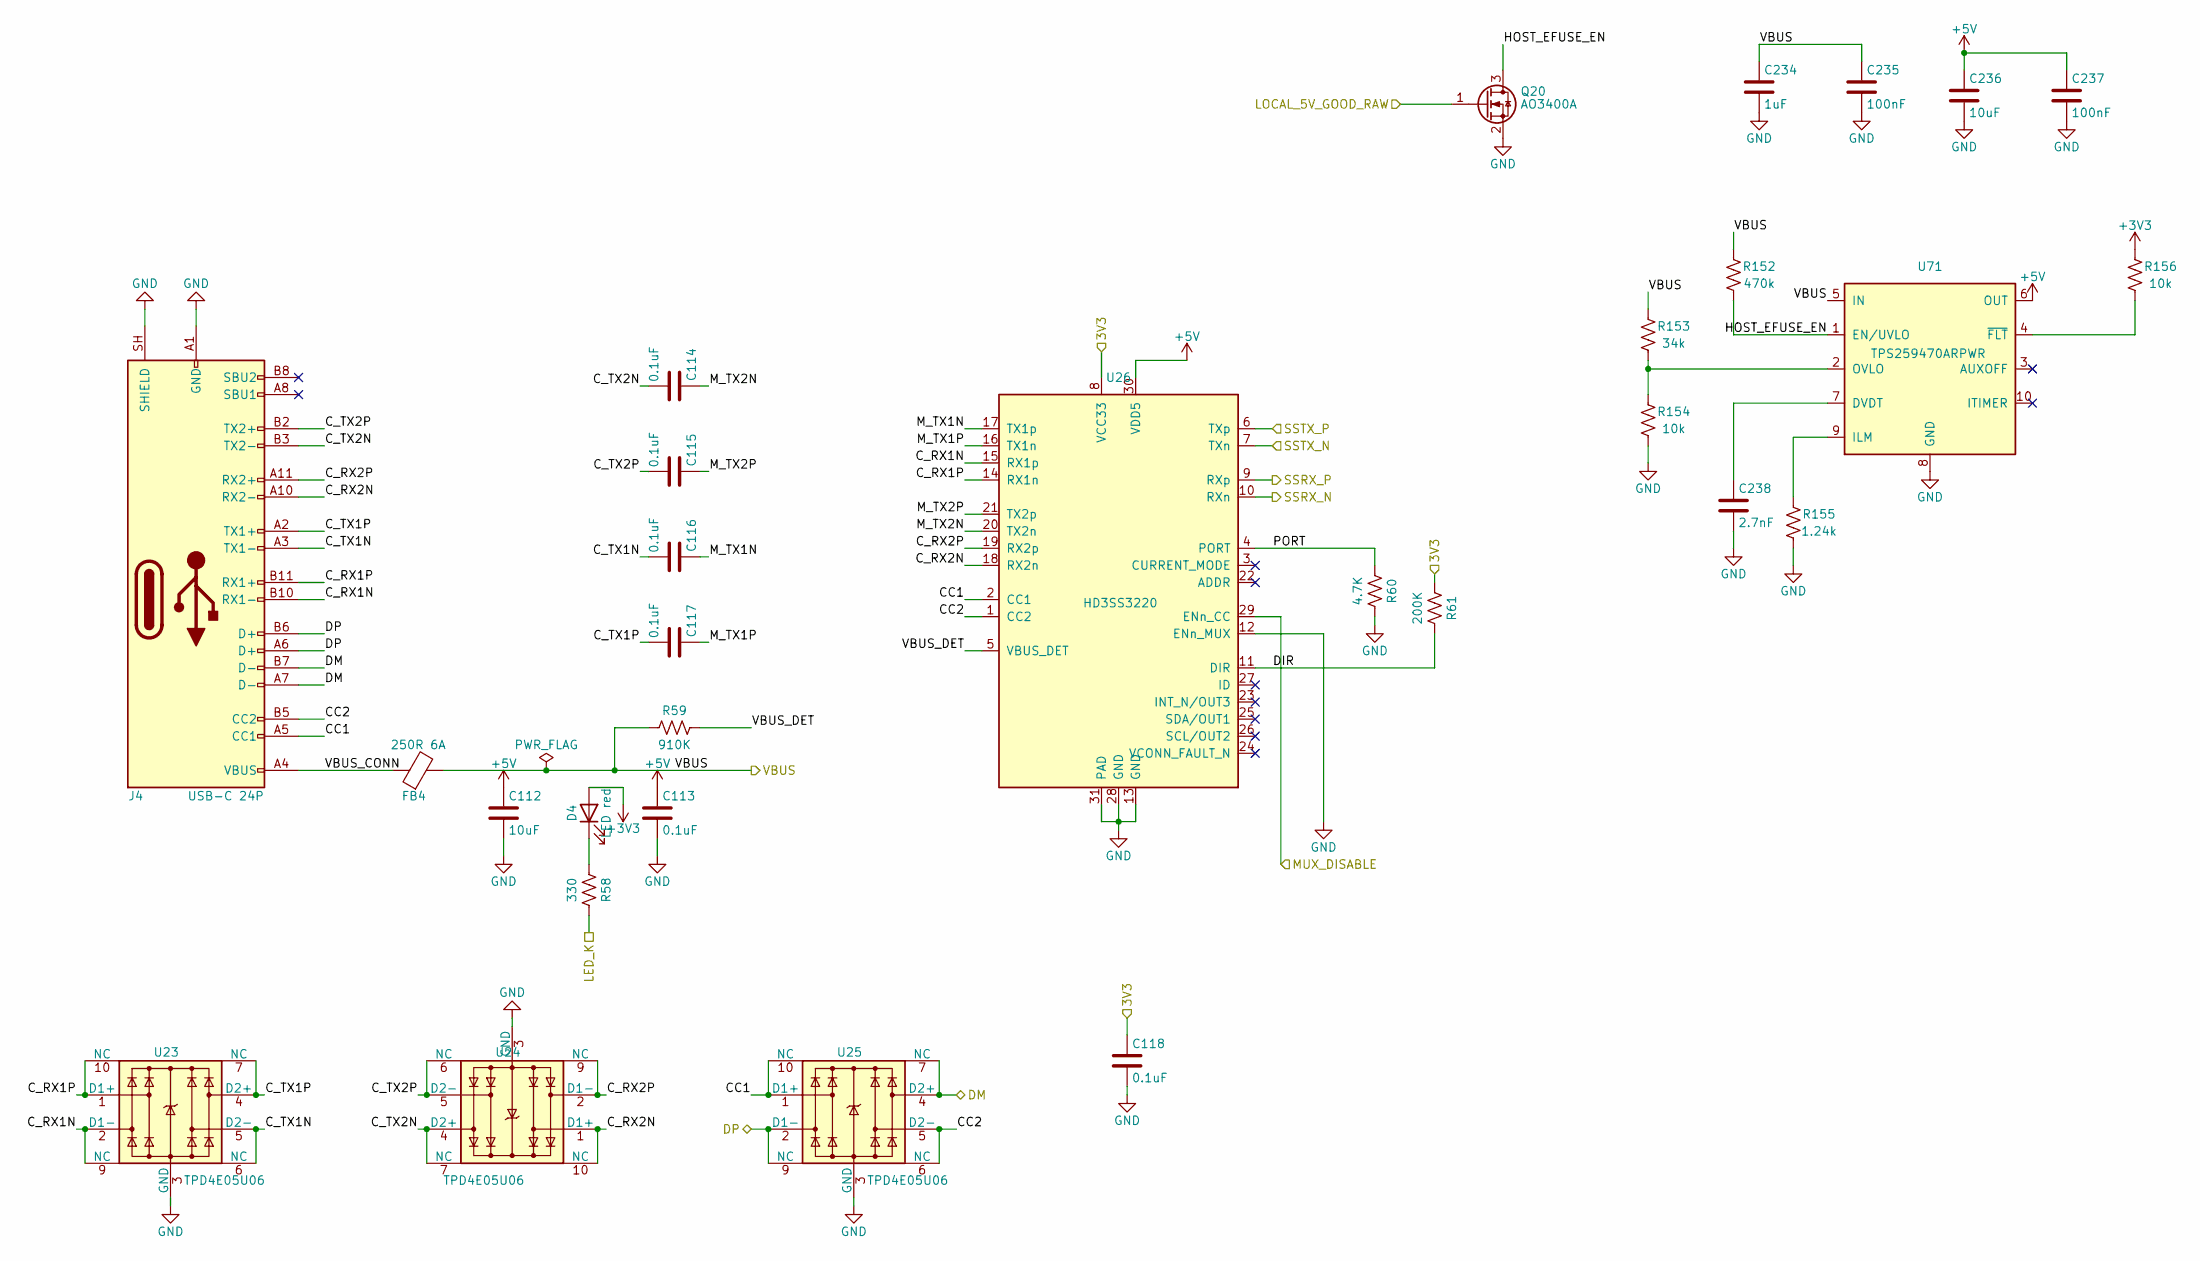
[picture p8: schematic usbc_ufp.kicad_sch]

Parts:
C112: 10uF; C_0805_2012Metric; LCSC C15850
C113, C114, C115, C116, C117, C118: 0.1uF; C_0402_1005Metric; LCSC C1525
C234: 1uF; C_0402_1005Metric; Voltage 25V; Tolerance 10%; MPN CL05A105KA5NQNC; LCSC C52923
C235, C237: 100nF; C_0402_1005Metric; Voltage 16V; LCSC C1525
C236: 10uF; C_0805_2012Metric; Voltage 25V; Tolerance 10%; MPN CL21A106KAYNNNE; LCSC C15850
C238: 2.7nF; C_0402_1005Metric; Tolerance 5%; Voltage 50V; MPN GRM1555C1H272JE01D; LCSC C1518205
D4: LED red; LED_0805_2012Metric; LCSC C84256
FB4: 250R 6A; FB_201210_PROD; MPN PSBHAA201210H-251T060; LCSC C48543401
J4: USB-C 24P; USB_C_Receptacle_Molex_105450-0101; MPN 105450-0101; LCSC C134092
Q20: AO3400A; SOT-23; MPN AO3400A; LCSC C20917
R58: 330; R_0402_1005Metric; LCSC C25104
R59: 910K; R_0402_1005Metric; LCSC C25800
R60: 4.7K; R_0402_1005Metric; LCSC C25900
R61: 200K; R_0402_1005Metric; LCSC C25764
R152: 470k; R_0402_1005Metric; Tolerance 1%; MPN 0402WGF4703TCE; LCSC C25790
R153: 34k; R_0402_1005Metric; Tolerance 0.1%; MPN RT0402BRD0734KL; LCSC C852733
R154: 10k; R_0402_1005Metric; Tolerance 0.1%; MPN RT0402BRD0710KL; LCSC C190095
R155: 1.24k; R_0402_1005Metric; Tolerance 1%; MPN 0402WGF1241TCE; LCSC C25864
R156: 10k; R_0402_1005Metric; Tolerance 1%; LCSC C25744
U23, U24, U25: TPD4E05U06; USON-10_2.5x1.0mm_P0.5mm; LCSC C138714
U26: HD3SS3220; Texas_RNH0030A_WQFN-30-1EP_2.5x4.5mm_P0.4mm_EP1.2x3.2mm; LCSC C165155
U71: TPS259470ARPWR; RPW0010A-MFG; MPN TPS259470ARPWR; LCSC C3662799

Connections:
+3V3: C118.1, D4.2 (A), R61.1, R156.1, U26.8 (VCC33); also elsewhere on the board
+5V: C112.1, C113.1, C236.1, C237.1, U26.30 (VDD5), U71.6 (OUT); also elsewhere on the board
/LOCAL_5V_GOOD_RAW: Q20.1 (G); also elsewhere on the board
/MUX_DISABLE: U26.29 (ENn_CC); also elsewhere on the board
/UP Port/CC1: J4.A5 (CC1), U25.1 (D1+), U25.10 (NC), U26.2 (CC1)
/UP Port/CC2: J4.B5 (CC2), U25.5 (D2-), U25.6 (NC), U26.1 (CC2)
/UP Port/C_RX1N: J4.B10 (RX1-), U23.2 (D1-), U23.9 (NC), U26.15 (RX1p)
/UP Port/C_RX1P: J4.B11 (RX1+), U23.1 (D1+), U23.10 (NC), U26.14 (RX1n)
/UP Port/C_RX2N: J4.A10 (RX2-), U24.1 (D1+), U24.10 (NC), U26.18 (RX2n)
/UP Port/C_RX2P: J4.A11 (RX2+), U24.2 (D1-), U24.9 (NC), U26.19 (RX2p)
/UP Port/C_TX1N: C116.2, J4.A3 (TX1-), U23.5 (D2-), U23.6 (NC)
/UP Port/C_TX1P: C117.2, J4.A2 (TX1+), U23.4 (D2+), U23.7 (NC)
/UP Port/C_TX2N: C114.2, J4.B3 (TX2-), U24.4 (D2+), U24.7 (NC)
/UP Port/C_TX2P: C115.2, J4.B2 (TX2+), U24.5 (D2-), U24.6 (NC)
/UP Port/DIR: R61.2, U26.11 (DIR)
/UP Port/HOST_EFUSE_EN: Q20.3 (D), R152.2, U71.1 (EN/UVLO)
/UP Port/M_TX1N: C116.1, U26.17 (TX1p)
/UP Port/M_TX1P: C117.1, U26.16 (TX1n)
/UP Port/M_TX2N: C114.1, U26.20 (TX2n)
/UP Port/M_TX2P: C115.1, U26.21 (TX2p)
/UP Port/PORT: R60.1, U26.4 (PORT)
/UP Port/VBUS_CONN: FB4.1, J4.A4 (VBUS), J4.A9 (VBUS), J4.B4 (VBUS), J4.B9 (VBUS)
/UP Port/VBUS_DET: R59.2, U26.5 (VBUS_DET)
/UP_D_N: J4.A7 (D-), J4.B7 (D-), U25.4 (D2+), U25.7 (NC); also elsewhere on the board
/UP_D_P: J4.A6 (D+), J4.B6 (D+), U25.2 (D1-), U25.9 (NC); also elsewhere on the board
/UP_SSRX_N: U26.10 (RXn); also elsewhere on the board
/UP_SSRX_P: U26.9 (RXp); also elsewhere on the board
/UP_SSTX_N: U26.7 (TXn); also elsewhere on the board
/UP_SSTX_P: U26.6 (TXp); also elsewhere on the board
/UP_VBUS: C234.1, C235.1, FB4.2, R59.1, R152.1, R153.1, U71.5 (IN); also elsewhere on the board
/USBLED_UP: R58.2; also elsewhere on the board
GND: C112.2, C113.2, C118.2, C234.2, C235.2, C236.2, C237.2, C238.2, J4.A1 (GND), J4.A12 (GND), J4.B1 (GND), J4.B12 (GND), J4.SH (SHIELD), Q20.2 (S), R60.2, R154.2, R155.2, U23.3 (GND), U23.8 (GND), U24.3 (GND), U24.8 (GND), U25.3 (GND), U25.8 (GND), U26.12 (ENn_MUX), U26.13 (GND), U26.28 (GND), U26.31 (PAD), U71.8 (GND); also elsewhere on the board
unnamed: D4.1 (K), R58.1
unnamed: C238.1, U71.7 (DVDT)
unnamed: R155.1, U71.9 (ILM)
unnamed: R153.2, R154.1, U71.2 (OVLO)
unnamed: R156.2, U71.4 (~FLT)
