mikefsq/scope_hub/pcb/scope_hub.kicad_pcb

## KiCad design pcb/scope_hub.kicad_pcb (continued)

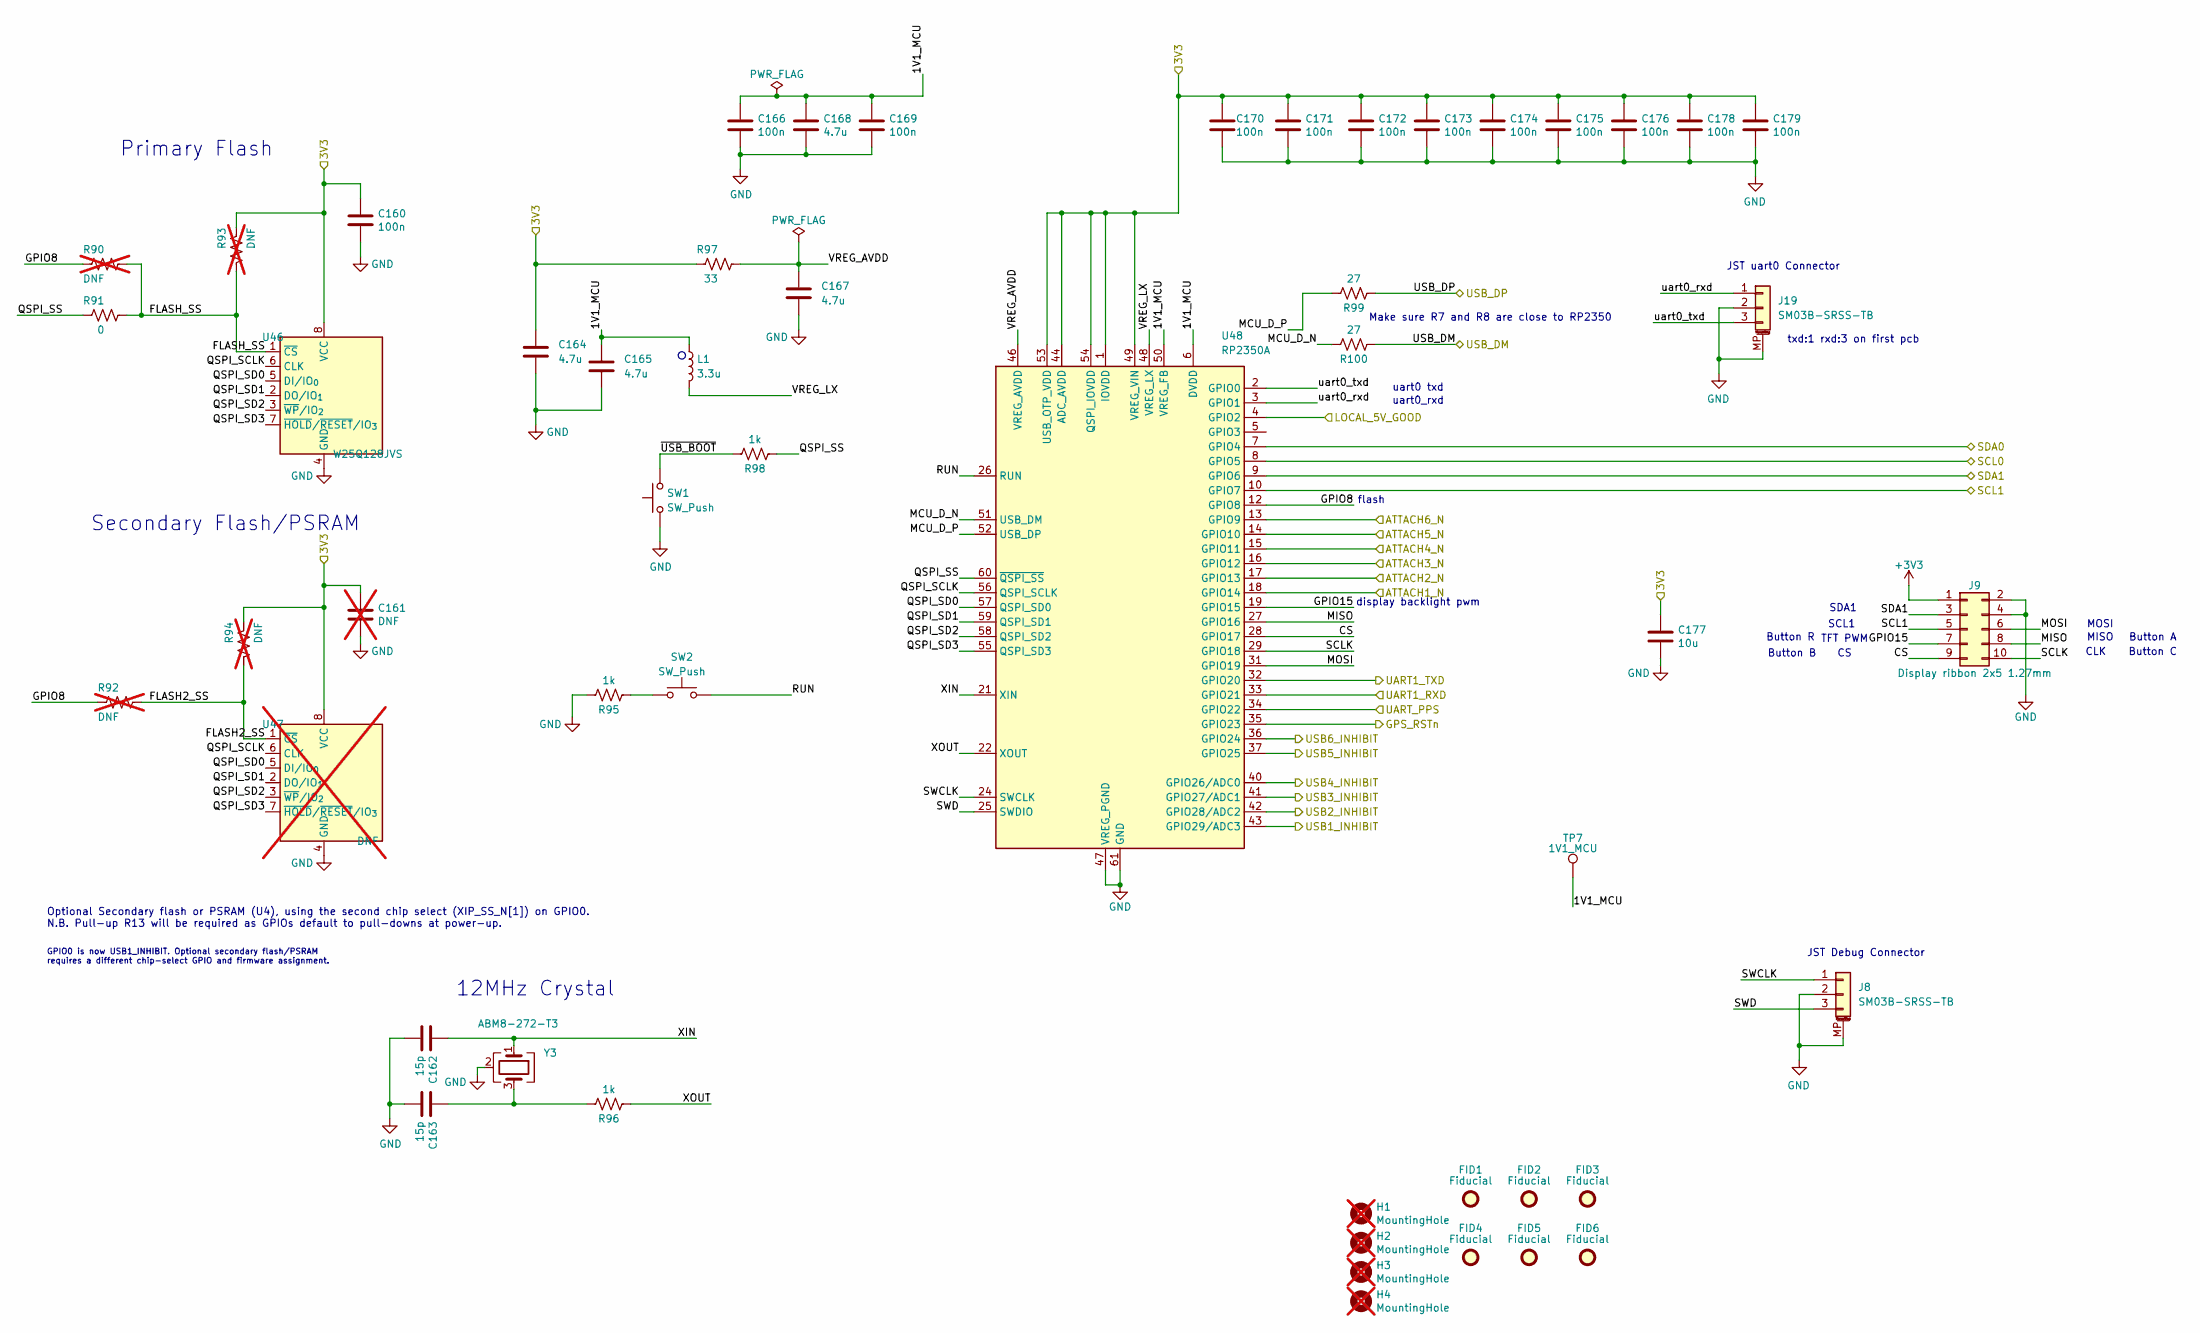
[picture p9: schematic rp2350a.kicad_sch]

Parts:
C160, C166, C169, C170, C171, C172, C173, C174, C175, C176, C178, C179: 100n; C_0402_1005Metric; LCSC C1525
C161: DNF; C_0402_1005Metric; not fitted
C162, C163: 15p; C_0402_1005Metric; LCSC C1548
C164, C165, C167, C168: 4.7u; C_0402_1005Metric; LCSC C23733
C177: 10u; C_0805_2012Metric; LCSC C15850
FID1, FID2, FID3, FID4, FID5, FID6: Fiducial; Fiducial_1mm_Mask3mm
H1, H2, H3, H4: MountingHole; MountingHole_3.2mm_M3; not fitted
J8, J19: SM03B-SRSS-TB; JST_SH_SM03B-SRSS-TB_1x03-1MP_P1.00mm_Horizontal; MPN SM03B-SRSS-TB(LF)(SN); LCSC C160403
J9: Display ribbon 2x5 1.27mm; PinHeader_2x05_P1.27mm_Vertical_SMD; MPN FTSH-105-01-L-DV-K-TR; LCSC C448647
L1: 3.3u; L_pol_2016; MPN AOTA-B201610S3R3-101-T; LCSC C42411119
R90, R92, R93, R94: DNF; R_0402_1005Metric; not fitted
R91: 0; R_0402_1005Metric; LCSC C17168
R95, R96, R98: 1k; R_0402_1005Metric; LCSC C11702
R97: 33; R_0402_1005Metric; LCSC C25105
R99, R100: 27; R_0402_1005Metric; LCSC C25100
SW1, SW2: SW_Push; SW_Push_1P1T_NO_Vertical_Wuerth_434133025816; MPN 434133025816; LCSC C5504987
TP7: 1V1_MCU; TestPoint_Pad_D1.5mm
U46: W25Q128JVS; SOIC-8_5.3x5.3mm_P1.27mm; MPN W25Q128JVSIQ; LCSC C97521
U47: DNF; SOIC-8_5.3x5.3mm_P1.27mm; not fitted
U48: RP2350A; QFN-60-1EP_7x7mm_P0.4mm_EP3.4x3.4mm_ThermalVias; LCSC C42411118
Y3: ABM8-272-T3; Crystal_SMD_3225-4Pin_3.2x2.5mm; MPN ABM8-272-T3; LCSC C20625731

Connections:
+3V3: C160.1, C161.1, C164.1, C170.1, C171.1, C172.1, C173.1, C174.1, C175.1, C176.1, C177.1, C178.1, C179.1, J9.1, R93.1, R94.1, R97.1, U46.8 (VCC), U47.8 (VCC), U48.1 (IOVDD), U48.11 (IOVDD), U48.20 (IOVDD), U48.30 (IOVDD), U48.38 (IOVDD), U48.44 (ADC_AVDD), U48.45 (IOVDD), U48.49 (VREG_VIN), U48.53 (USB_OTP_VDD), U48.54 (QSPI_IOVDD); also elsewhere on the board
/ATTACH1_N: U48.18 (GPIO14); also elsewhere on the board
/ATTACH2_N: U48.17 (GPIO13); also elsewhere on the board
/ATTACH3_N: U48.16 (GPIO12); also elsewhere on the board
/ATTACH4_N: U48.15 (GPIO11); also elsewhere on the board
/ATTACH5_N: U48.14 (GPIO10); also elsewhere on the board
/ATTACH6_N: U48.13 (GPIO9); also elsewhere on the board
/GPS_PPS: U48.34 (GPIO22); also elsewhere on the board
/GPS_RSTn: U48.35 (GPIO23); also elsewhere on the board
/GPS_RXD: U48.32 (GPIO20); also elsewhere on the board
/GPS_TXD: U48.33 (GPIO21); also elsewhere on the board
/I2C0_SCL: U48.8 (GPIO5); also elsewhere on the board
/I2C0_SDA: U48.7 (GPIO4); also elsewhere on the board
/I2C1_SCL: J9.5, U48.10 (GPIO7); also elsewhere on the board
/I2C1_SDA: J9.3, U48.9 (GPIO6); also elsewhere on the board
/LOCAL_5V_GOOD: U48.4 (GPIO2); also elsewhere on the board
/PICO_D_N: R100.1; also elsewhere on the board
/PICO_D_P: R99.1; also elsewhere on the board
/RP2350A/1V1_MCU: C165.1, C166.1, C168.1, C169.1, L1.1, TP7.1 (1_1), U48.6 (DVDD), U48.23 (DVDD), U48.39 (DVDD), U48.50 (VREG_FB)
/RP2350A/CS: J9.9, U48.28 (GPIO17)
/RP2350A/FLASH2_SS: R92.2, R94.2, U47.1 (~CS)
/RP2350A/FLASH_SS: R90.2, R91.2, R93.2, U46.1 (~CS)
/RP2350A/GPIO8: R90.1, R92.1, U48.12 (GPIO8)
/RP2350A/GPIO15: J9.7, U48.19 (GPIO15)
/RP2350A/MCU_D_N: R100.2, U48.51 (USB_DM)
/RP2350A/MCU_D_P: R99.2, U48.52 (USB_DP)
/RP2350A/MISO: J9.8, U48.27 (GPIO16)
/RP2350A/MOSI: J9.6, U48.31 (GPIO19)
/RP2350A/QSPI_SCLK: U46.6 (CLK), U47.6 (CLK), U48.56 (QSPI_SCLK)
/RP2350A/QSPI_SD0: U46.5 (DI/IO_{0}), U47.5 (DI/IO_{0}), U48.57 (QSPI_SD0)
/RP2350A/QSPI_SD1: U46.2 (DO/IO_{1}), U47.2 (DO/IO_{1}), U48.59 (QSPI_SD1)
/RP2350A/QSPI_SD2: U46.3 (~WP/IO_{2}), U47.3 (~WP/IO_{2}), U48.58 (QSPI_SD2)
/RP2350A/QSPI_SD3: U46.7 (~HOLD/~RESET/IO_{3}), U47.7 (~HOLD/~RESET/IO_{3}), U48.55 (QSPI_SD3)
/RP2350A/QSPI_SS: R91.1, R98.1, U48.60 (~QSPI_SS)
/RP2350A/RUN: SW2.2, U48.26 (RUN)
/RP2350A/SCLK: J9.10, U48.29 (GPIO18)
/RP2350A/SWCLK: J8.1, U48.24 (SWCLK)
/RP2350A/SWD: J8.3, U48.25 (SWDIO)
/RP2350A/VREG_AVDD: C167.1, R97.2, U48.46 (VREG_AVDD)
/RP2350A/VREG_LX: L1.2, U48.48 (VREG_LX)
/RP2350A/XIN: C162.1, U48.21 (XIN), Y3.1
/RP2350A/XOUT: R96.1, U48.22 (XOUT)
/RP2350A/uart0_rxd: J19.1, U48.3 (GPIO1)
/RP2350A/uart0_txd: J19.3, U48.2 (GPIO0)
/RP2350A/~USB_BOOT: R98.2, SW1.2
/USB1_INHIBIT: U48.43 (GPIO29/ADC3); also elsewhere on the board
/USB2_INHIBIT: U48.42 (GPIO28/ADC2); also elsewhere on the board
/USB3_INHIBIT: U48.41 (GPIO27/ADC1); also elsewhere on the board
/USB4_INHIBIT: U48.40 (GPIO26/ADC0); also elsewhere on the board
/USB5_INHIBIT: U48.37 (GPIO25); also elsewhere on the board
/USB6_INHIBIT: U48.36 (GPIO24); also elsewhere on the board
GND: C160.2, C161.2, C162.2, C163.2, C164.2, C165.2, C166.2, C167.2, C168.2, C169.2, C170.2, C171.2, C172.2, C173.2, C174.2, C175.2, C176.2, C177.2, C178.2, C179.2, J8.2, J8.MP (MountPin), J9.2, J9.4, J19.2, J19.MP (MountPin), R95.2, SW1.1, U46.4 (GND), U47.4 (GND), U48.47 (VREG_PGND), U48.61 (GND), Y3.2 (G), Y3.4 (G); also elsewhere on the board
unnamed: C163.1, R96.2, Y3.3
unnamed: R95.1, SW2.1

Notes on the sheet:
Button A
display backlight pwm
Secondary Flash/PSRAM
JST Debug Connector
12MHz Crystal
GPIO0 is now USB1_INHIBIT. Optional secondary flash/PSRAM requires a different chip-select GPIO and firmware assignment.
MOSI
uart0_rxd
SCL1
uart0 txd
Optional Secondary flash or PSRAM (U4), using the second chip select (XIP_SS_N[1]) on GPIO0. N.B. Pull-up R13 will be required as GPIOs default to pull-downs at power-up.
flash
MISO
Button R
TFT PWM
txd:1 rxd:3 on first pcb
SDA1
JST uart0 Connector
Button C
Make sure R7 and R8 are close to RP2350
CLK
Button B
Primary Flash

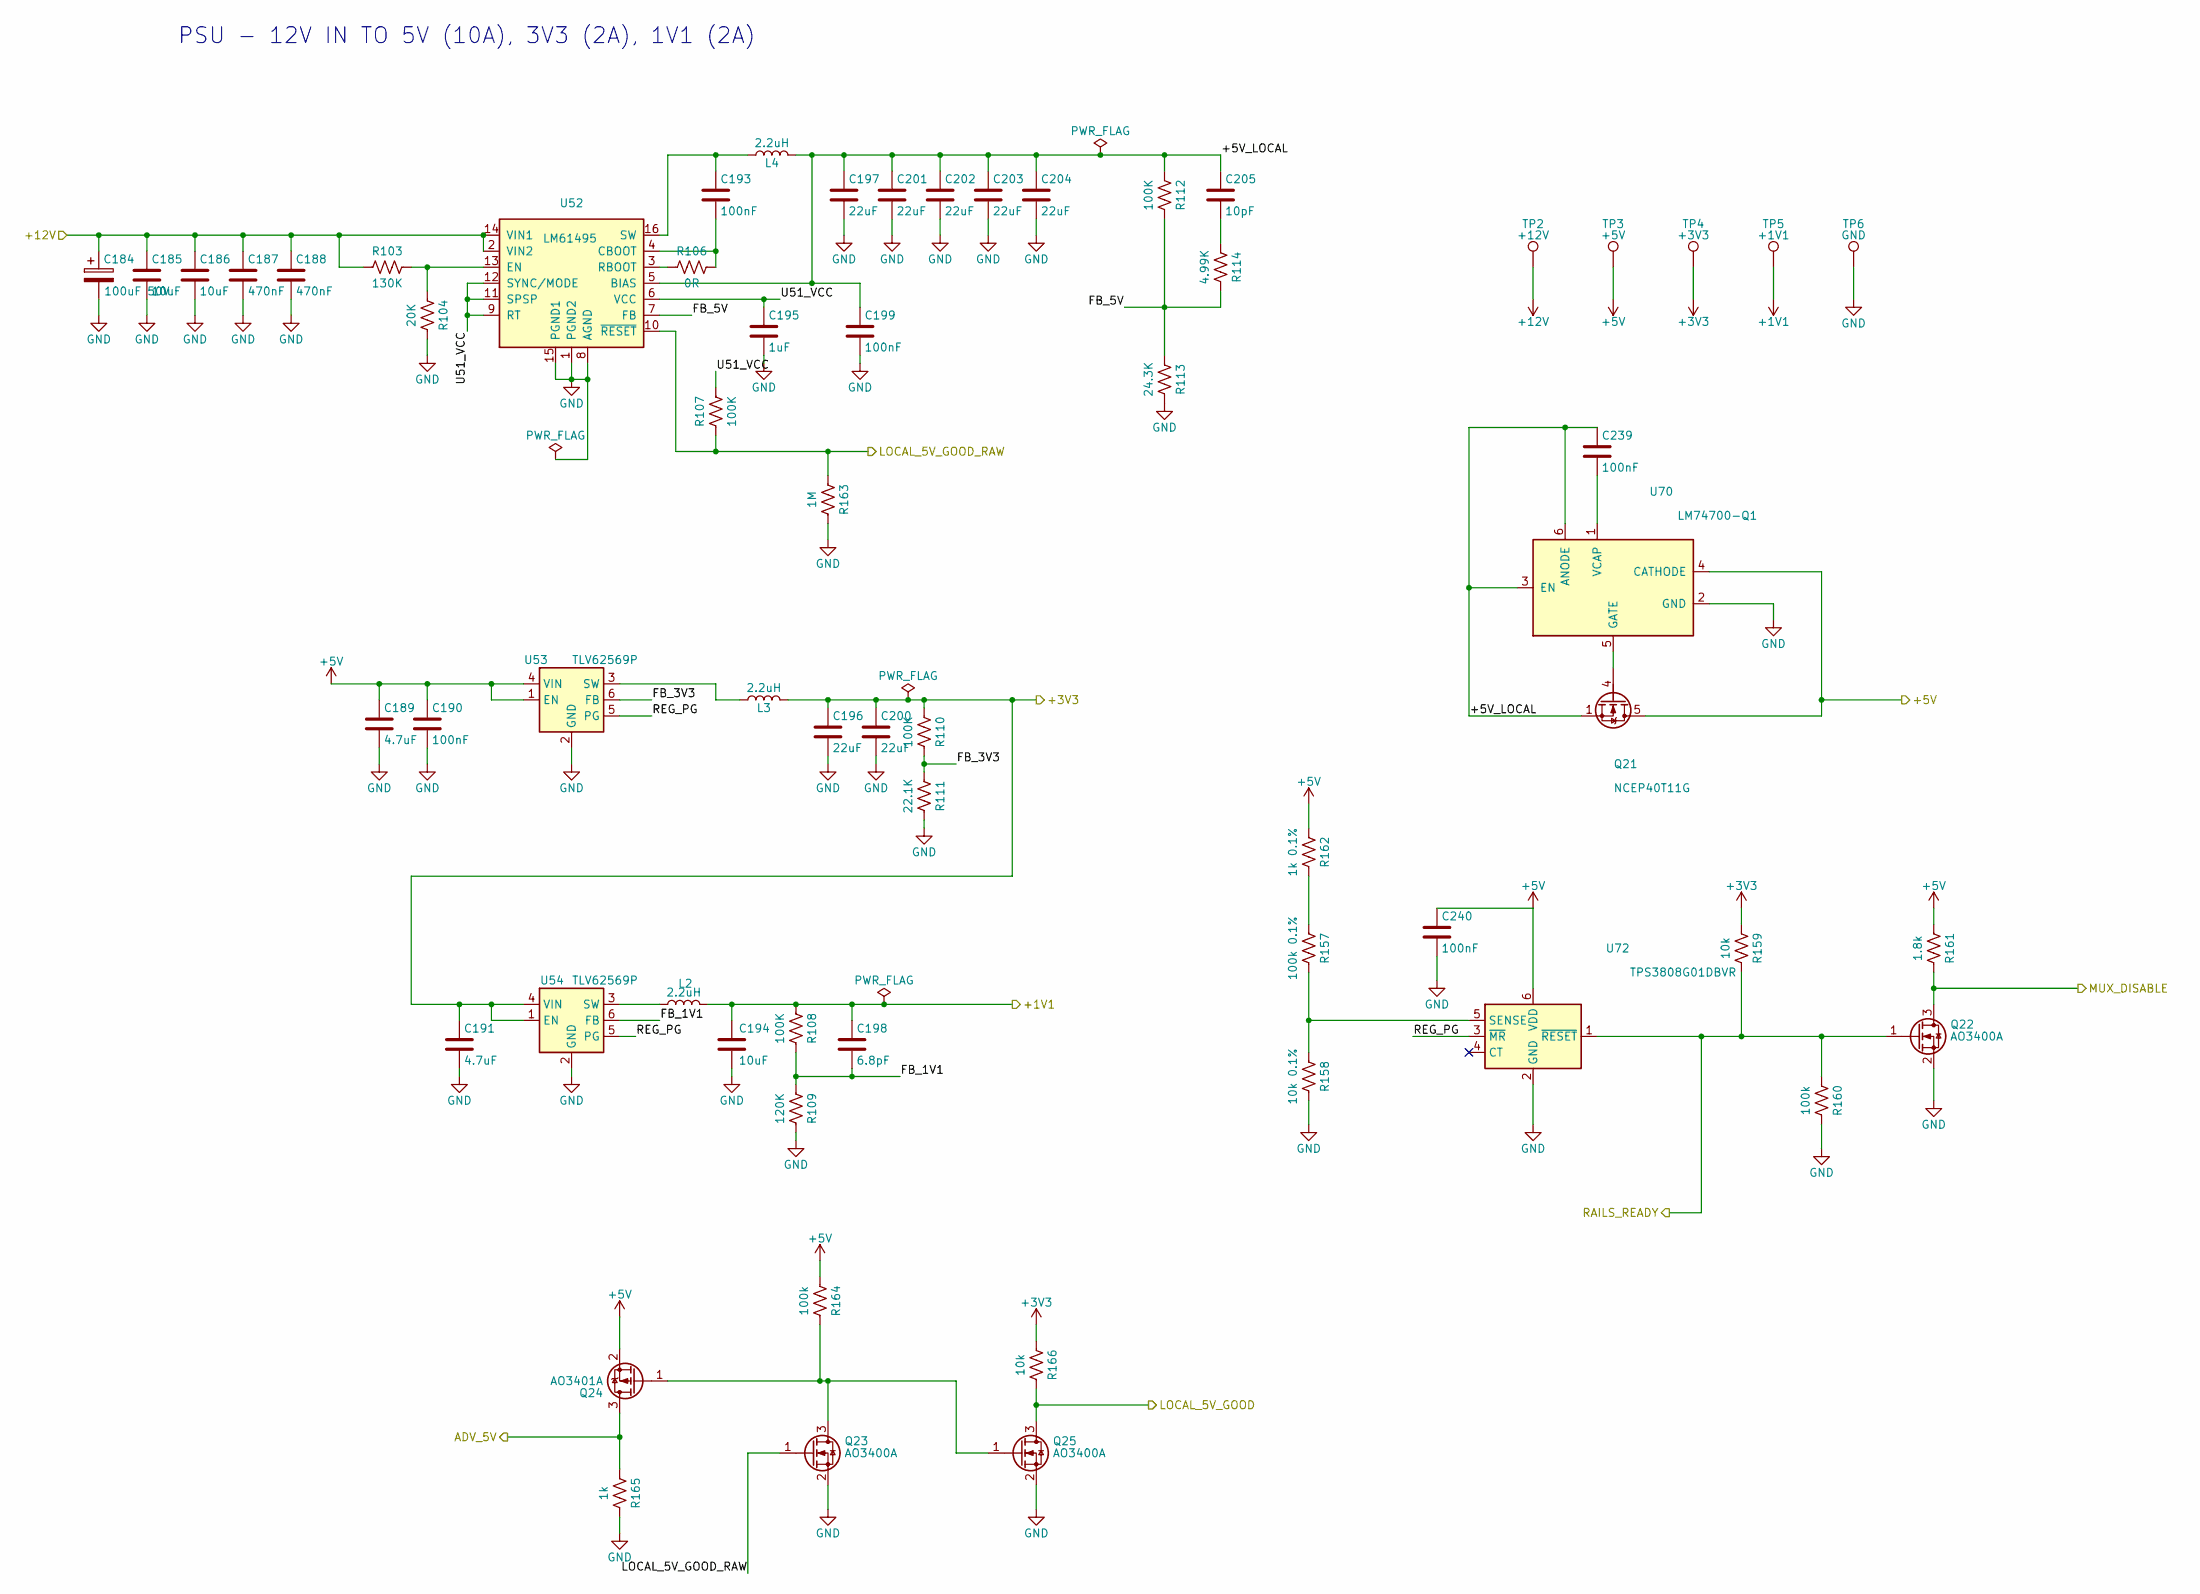
[picture p10: schematic psu.kicad_sch]

Parts:
C184: 100uF 50V; CP_Elec_6.3x7.7; LCSC C2980173
C185, C186: 10uF; C_1210_3225Metric; LCSC C386166
C187, C188: 470nF; C_0603_1608Metric; LCSC C513577
C189: 4.7uF; C_1206_3216Metric; LCSC C51205
C190: 100nF; C_0603_1608Metric; LCSC C14663
C191: 4.7uF; C_0805_2012Metric; LCSC C354262
C193, C199, C240: 100nF; C_0402_1005Metric; LCSC C1525
C194: 10uF; C_0805_2012Metric; LCSC C15850
C195: 1uF; C_0603_1608Metric; LCSC C5199872
C196, C200: 22uF; C_0805_2012Metric; LCSC C98190
C197, C201, C202, C203, C204: 22uF; C_1210_3225Metric; LCSC C309062
C198: 6.8pF; C_0402_1005Metric; LCSC C189470
C205: 10pF; C_0402_1005Metric; LCSC C106199
C239: 100nF; C_0603_1608Metric; Voltage 50V; MPN CC0603KRX7R9BB104; LCSC C14663
L2: 2.2uH; L_Sunlord_SWPA4020S; LCSC C83423
L3: 2.2uH; L_Sunlord_SWPA4020S; MPN SWPA4020S2R2MT; LCSC C83423
L4: 2.2uH; L_Changjiang_FXL1040; LCSC C167228
Q21: NCEP40T11G; PowerPAK_SO-8_Single; MPN NCEP40T11G; LCSC C182465
Q22, Q23, Q25: AO3400A; SOT-23; MPN AO3400A; LCSC C20917
Q24: AO3401A; SOT-23; MPN AO3401A; LCSC C15127
R103: 130K; R_0402_1005Metric; LCSC C93946
R104: 20K; R_0402_1005Metric; LCSC C25765
R106: 0R; R_0402_1005Metric; LCSC C2906858
R107, R108, R110, R112: 100K; R_0402_1005Metric; LCSC C25741
R109: 120K; R_0402_1005Metric; LCSC C25750
R111: 22.1K; R_0402_1005Metric; LCSC C163478
R113: 24.3K; R_0402_1005Metric; LCSC C26969
R114: 4.99K; R_0402_1005Metric; LCSC C2933102
R157: 100k 0.1%; R_0402_1005Metric; Tolerance 0.1%; MPN RT0402BRD07100KL; LCSC C852472
R158: 10k 0.1%; R_0402_1005Metric; Tolerance 0.1%; MPN RT0402BRD0710KL; LCSC C190095
R159: 10k; R_0402_1005Metric; Tolerance 1%; LCSC C25744
R160: 100k; R_0402_1005Metric; Tolerance 1%; LCSC C25741
R161: 1.8k; R_0402_1005Metric; Tolerance 1%; MPN RC0402FR-071K8L; LCSC C163481
R162: 1k 0.1%; R_0402_1005Metric; Tolerance 0.1%; MPN RT0402BRD071KL; LCSC C852624
R163: 1M; R_0402_1005Metric; LCSC C26083
R164: 100k; R_0402_1005Metric; LCSC C25741
R165: 1k; R_0402_1005Metric; LCSC C11702
R166: 10k; R_0402_1005Metric; LCSC C25744
TP2: +12V; TestPoint_Pad_D1.5mm
TP3: +5V; TestPoint_Pad_D1.5mm
TP4: +3V3; TestPoint_Pad_D1.5mm
TP5: +1V1; TestPoint_Pad_D1.5mm
TP6: GND; TestPoint_Pad_D1.5mm
U52: LM61495; Texas_RPH0016A_VQFN-HR-16_3.5x4.5mm; MPN LM61495RPHR; LCSC C2943584
U53, U54: TLV62569P; TSOT-23-6; MPN TLV62569PDDCR; LCSC C398365
U70: LM74700-Q1; SOT-23-6; MPN LM74700QDBVRQ1; LCSC C2941042
U72: TPS3808G01DBVR; SOT-23-6; MPN TPS3808G01DBVR; LCSC C19653

Connections:
+1V1: C194.1, C198.1, L2.2, R108.1, TP5.1 (1_1); also elsewhere on the board
+3V3: C191.1, C196.1, C200.1, L3.2, R110.1, R159.1, R166.1, TP4.1 (1_1), U54.1 (EN), U54.4 (VIN); also elsewhere on the board
+5V: C189.1, C190.1, C240.1, Q21.5 (D), Q24.2 (S), R161.1, R162.1, R164.1, TP3.1 (1_1), U53.1 (EN), U53.4 (VIN), U70.4 (CATHODE), U72.6 (VDD); also elsewhere on the board
+12V: C184.1, C185.1, C186.1, C187.1, C188.1, R103.1, TP2.1 (1_1), U52.2 (VIN2), U52.14 (VIN1); also elsewhere on the board
/ADV_5V: Q24.3 (D), R165.1; also elsewhere on the board
/LOCAL_5V_GOOD: Q25.3 (D), R166.2; also elsewhere on the board
/LOCAL_5V_GOOD_RAW: Q23.1 (G), R107.1, R163.1, U52.10 (~RESET); also elsewhere on the board
/MUX_DISABLE: Q22.3 (D), R161.2; also elsewhere on the board
/PSU 12V to 5V/3V3/1V1/+5V_LOCAL: C197.1, C199.1, C201.1, C202.1, C203.1, C204.1, C205.1, C239.1, L4.2, Q21.1 (S), Q21.2 (S), Q21.3 (S), R112.1, U52.5 (BIAS), U70.3 (EN), U70.6 (ANODE)
/PSU 12V to 5V/3V3/1V1/FB_1V1: C198.2, R108.2, R109.1, U54.6 (FB)
/PSU 12V to 5V/3V3/1V1/FB_3V3: R110.2, R111.1, U53.6 (FB)
/PSU 12V to 5V/3V3/1V1/FB_5V: R112.2, R113.1, R114.2, U52.7 (FB)
/PSU 12V to 5V/3V3/1V1/REG_PG: U53.5 (PG), U54.5 (PG), U72.3 (~MR)
/PSU 12V to 5V/3V3/1V1/U51_VCC: C195.1, R107.2, U52.6 (VCC), U52.9 (RT), U52.11 (SPSP), U52.12 (SYNC/MODE)
/RAILS_READY: Q22.1 (G), R159.2, R160.1, U72.1 (~RESET); also elsewhere on the board
GND: C184.2, C185.2, C186.2, C187.2, C188.2, C189.2, C190.2, C191.2, C194.2, C195.2, C196.2, C197.2, C199.2, C200.2, C201.2, C202.2, C203.2, C204.2, C240.2, Q22.2 (S), Q23.2 (S), Q25.2 (S), R104.2, R109.2, R111.2, R113.2, R158.2, R160.2, R163.2, R165.2, TP6.1 (1_1), U52.1 (PGND2), U52.8 (AGND), U52.15 (PGND1), U53.2 (GND), U54.2 (GND), U70.2 (GND), U72.2 (GND); also elsewhere on the board
unnamed: C205.2, R114.1
unnamed: Q21.4 (G), U70.5 (GATE)
unnamed: Q23.3 (D), Q24.1 (G), Q25.1 (G), R164.2
unnamed: R157.1, R162.2
unnamed: C193.2, R106.2, U52.4 (CBOOT)
unnamed: R103.2, R104.1, U52.13 (EN)
unnamed: R106.1, U52.3 (RBOOT)
unnamed: C193.1, L4.1, U52.16 (SW)
unnamed: L3.1, U53.3 (SW)
unnamed: L2.1, U54.3 (SW)
unnamed: C239.2, U70.1 (VCAP)
unnamed: R157.2, R158.1, U72.5 (SENSE)

Notes on the sheet:
PSU - 12V IN TO 5V (10A), 3V3 (2A), 1V1 (2A)

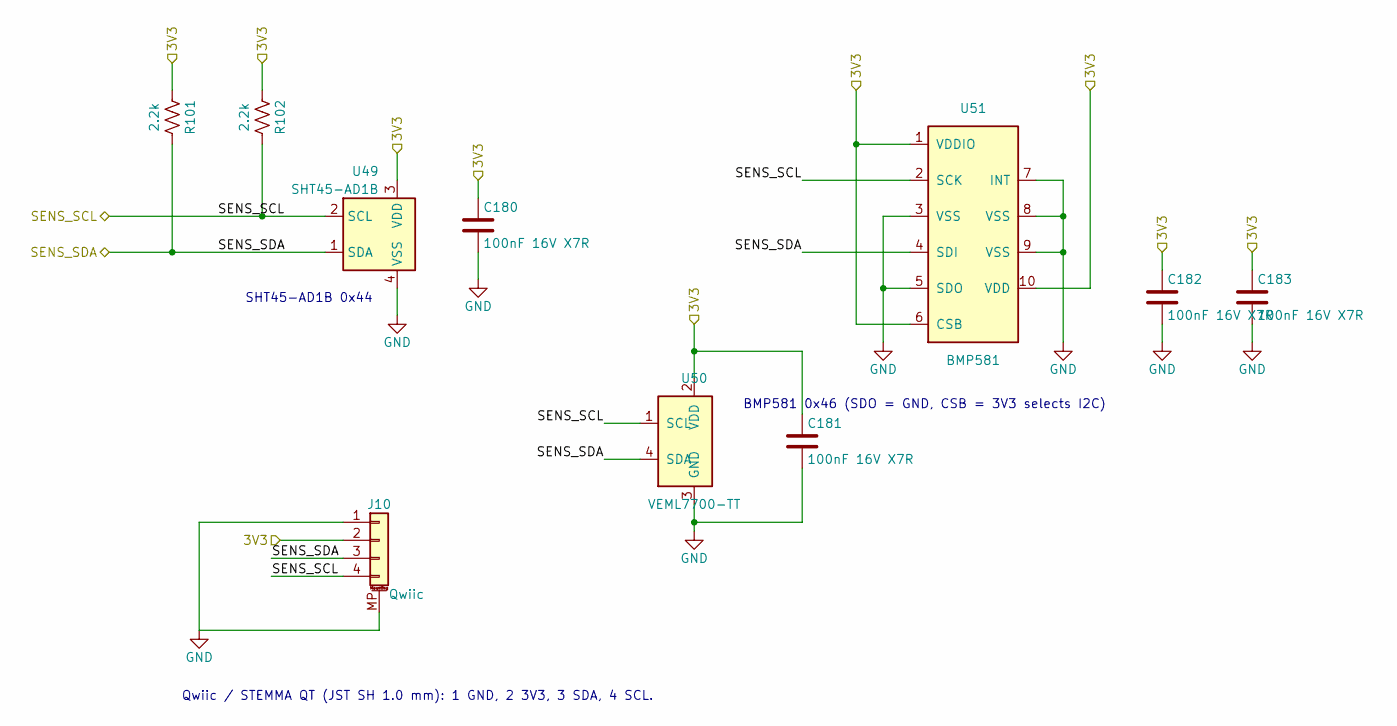
[picture p11: schematic sensors.kicad_sch]

Parts:
C180, C181, C182, C183: 100nF 16V X7R; C_0402_1005Metric; LCSC C1525
J10: Qwiic; JST_SH_SM04B-SRSS-TB_1x04-1MP_P1.00mm_Horizontal; LCSC C160404
R101, R102: 2.2k; R_0402_1005Metric; LCSC C25879
U49: SHT45-AD1B; Sensirion_DFN-4_1.5x1.5mm_P0.8mm_SHT4x_NoCentralPad; LCSC C5221601
U50: VEML7700-TT; Vishay_VEML7700-TT; MPN VEML7700-TT; LCSC C1850416
U51: BMP581; Bosch_LGA-10_2x2mm_P0.5mm_BMP581; LCSC C5362283

Connections:
+3V3: C180.1, C181.1, C182.1, C183.1, J10.2, R101.1, R102.1, U49.3 (VDD), U50.2 (VDD), U51.1 (VDDIO), U51.6 (CSB), U51.10 (VDD); also elsewhere on the board
/I2C1_SCL: J10.4, R102.2, U49.2 (SCL), U50.1 (SCL), U51.2 (SCK); also elsewhere on the board
/I2C1_SDA: J10.3, R101.2, U49.1 (SDA), U50.4 (SDA), U51.4 (SDI); also elsewhere on the board
GND: C180.2, C181.2, C182.2, C183.2, J10.1, J10.MP (MountPin), U49.4 (VSS), U50.3 (GND), U51.3 (VSS), U51.5 (SDO), U51.7 (INT), U51.8 (VSS), U51.9 (VSS); also elsewhere on the board

Notes on the sheet:
BMP581 0x46 (SDO = GND, CSB = 3V3 selects I2C)
Qwiic / STEMMA QT (JST SH 1.0 mm): 1 GND, 2 3V3, 3 SDA, 4 SCL.
SHT45-AD1B 0x44

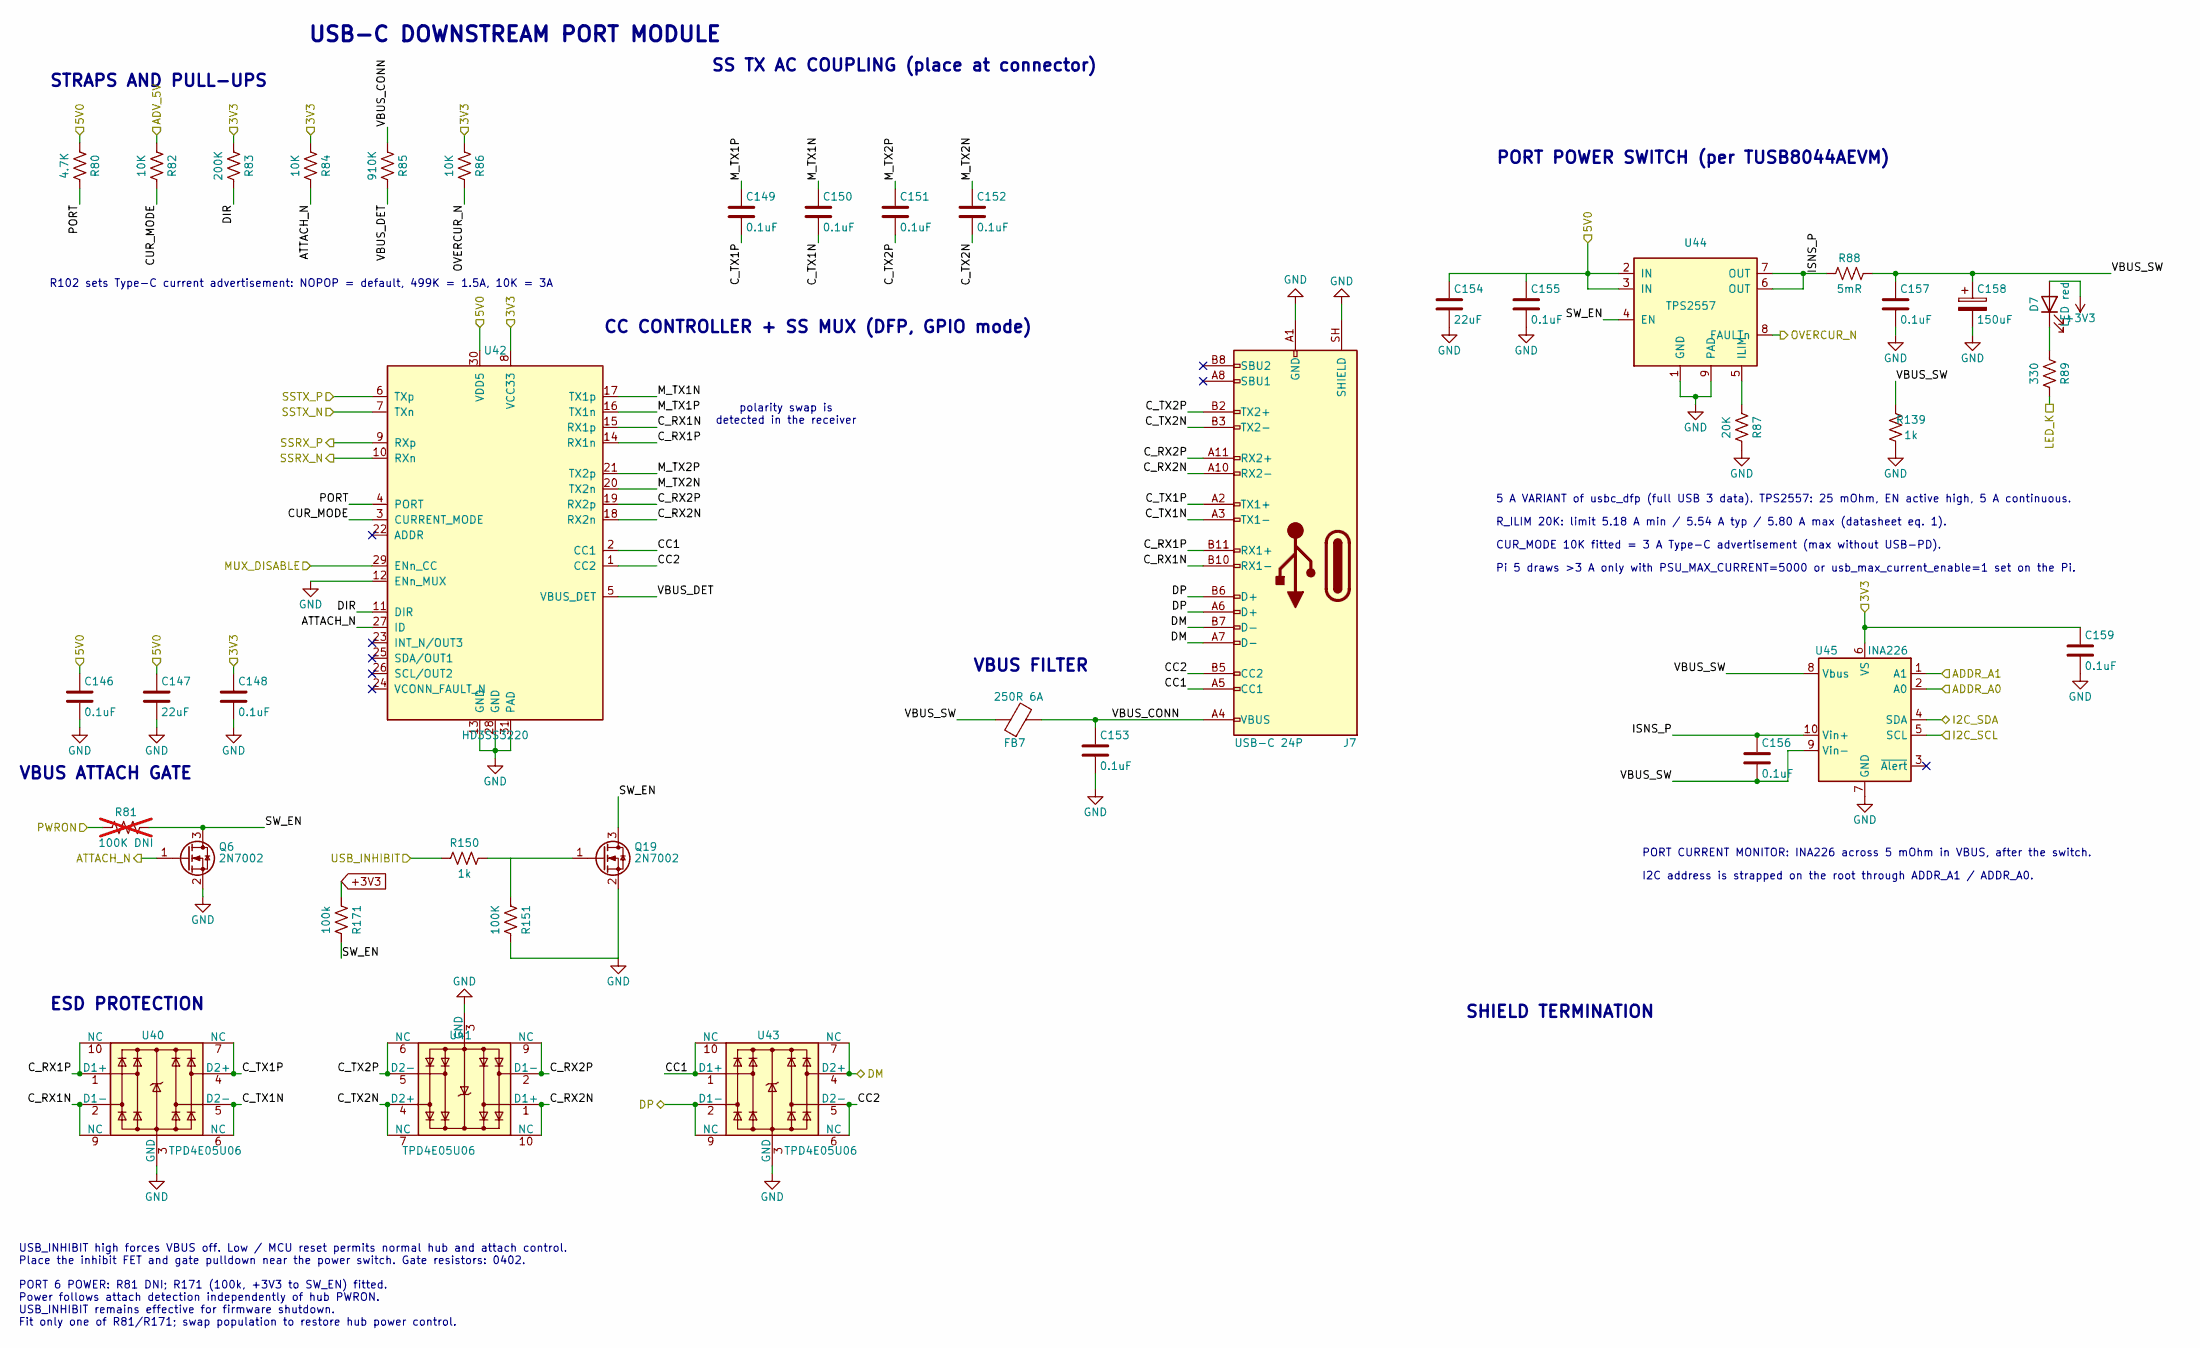
[picture p12: schematic usbc_pwr5a.kicad_sch]

Parts:
C146, C148, C149, C150, C151, C152, C153, C155, C156, C157, C159: 0.1uF; C_0402_1005Metric; LCSC C1525
C147, C154: 22uF; C_0805_2012Metric; LCSC C45783
C158: 150uF; CP_EIA-3528-21_Kemet-B; LCSC C212682
D7: LED red; LED_0805_2012Metric; LCSC C84256
FB7: 250R 6A; FB_201210_PROD; MPN PSBHAA201210H-251T060; LCSC C48543401
J7: USB-C 24P; USB_C_Receptacle_Molex_105450-0101; MPN 105450-0101; LCSC C134092
Q6: 2N7002; SOT-23; LCSC C8545
Q19: 2N7002; SOT-23; MPN 2N7002; LCSC C8545
R80: 4.7K; R_0402_1005Metric; LCSC C25900
R81: 100K DNI; R_0402_1005Metric; LCSC C25741; not fitted
R82, R84, R86: 10K; R_0402_1005Metric; LCSC C25744
R83: 200K; R_0402_1005Metric; LCSC C25764
R85: 910K; R_0402_1005Metric; LCSC C25800
R87: 20K; R_0402_1005Metric; LCSC C25765
R88: 5mR; R_1206_3216Metric; LCSC C7419996
R89: 330; R_0402_1005Metric; LCSC C25104
R139: 1k; R_0402_1005Metric; MPN 0402WGF1001TCE; LCSC C11702
R150: 1k; R_0402_1005Metric; LCSC C11702
R151: 100K; R_0402_1005Metric; LCSC C25741
R171: 100k; R_0402_1005Metric; LCSC C25741
U40, U41, U43: TPD4E05U06; USON-10_2.5x1.0mm_P0.5mm; LCSC C138714
U42: HD3SS3220; Texas_RNH0030A_WQFN-30-1EP_2.5x4.5mm_P0.4mm_EP1.2x3.2mm; LCSC C165155
U44: TPS2557; VSON-8-1EP_3x3mm_P0.65mm_EP1.65x2.4mm; LCSC C130056
U45: INA226; TSSOP-10_3x3mm_P0.5mm; MPN INA226AIDGSR; LCSC C49851

Connections:
+3V3: C148.1, C159.1, D7.2 (A), R83.1, R84.1, R86.1, R171.1, U42.8 (VCC33), U45.6 (VS); also elsewhere on the board
+5V: C146.1, C147.1, C154.1, C155.1, R80.1, U42.30 (VDD5), U44.2 (IN), U44.3 (IN); also elsewhere on the board
/ADV_5V: R82.1; also elsewhere on the board
/ATTACH6_N: Q6.1 (G), R84.2, U42.27 (ID); also elsewhere on the board
/DN6_D_N: J7.A7 (D-), J7.B7 (D-), U43.4 (D2+), U43.7 (NC); also elsewhere on the board
/DN6_D_P: J7.A6 (D+), J7.B6 (D+), U43.2 (D1-), U43.9 (NC); also elsewhere on the board
/DN Port 6 (5A)/CC1: J7.A5 (CC1), U42.2 (CC1), U43.1 (D1+), U43.10 (NC)
/DN Port 6 (5A)/CC2: J7.B5 (CC2), U42.1 (CC2), U43.5 (D2-), U43.6 (NC)
/DN Port 6 (5A)/CUR_MODE: R82.2, U42.3 (CURRENT_MODE)
/DN Port 6 (5A)/C_RX1N: J7.B10 (RX1-), U40.2 (D1-), U40.9 (NC), U42.15 (RX1p)
/DN Port 6 (5A)/C_RX1P: J7.B11 (RX1+), U40.1 (D1+), U40.10 (NC), U42.14 (RX1n)
/DN Port 6 (5A)/C_RX2N: J7.A10 (RX2-), U41.1 (D1+), U41.10 (NC), U42.18 (RX2n)
/DN Port 6 (5A)/C_RX2P: J7.A11 (RX2+), U41.2 (D1-), U41.9 (NC), U42.19 (RX2p)
/DN Port 6 (5A)/C_TX1N: C150.2, J7.A3 (TX1-), U40.5 (D2-), U40.6 (NC)
/DN Port 6 (5A)/C_TX1P: C149.2, J7.A2 (TX1+), U40.4 (D2+), U40.7 (NC)
/DN Port 6 (5A)/C_TX2N: C152.2, J7.B3 (TX2-), U41.4 (D2+), U41.7 (NC)
/DN Port 6 (5A)/C_TX2P: C151.2, J7.B2 (TX2+), U41.5 (D2-), U41.6 (NC)
/DN Port 6 (5A)/DIR: R83.2, U42.11 (DIR)
/DN Port 6 (5A)/ISNS_P: C156.1, R88.1, U44.6 (OUT), U44.7 (OUT), U45.10 (Vin+)
/DN Port 6 (5A)/M_TX1N: C150.1, U42.17 (TX1p)
/DN Port 6 (5A)/M_TX1P: C149.1, U42.16 (TX1n)
/DN Port 6 (5A)/M_TX2N: C152.1, U42.20 (TX2n)
/DN Port 6 (5A)/M_TX2P: C151.1, U42.21 (TX2p)
/DN Port 6 (5A)/OVERCUR_N: R86.2, U44.8 (FAULTn); also elsewhere on the board
/DN Port 6 (5A)/PORT: R80.2, U42.4 (PORT)
/DN Port 6 (5A)/SSRX_N: U42.10 (RXn); also elsewhere on the board
/DN Port 6 (5A)/SSRX_P: U42.9 (RXp); also elsewhere on the board
/DN Port 6 (5A)/SSTX_N: U42.7 (TXn); also elsewhere on the board
/DN Port 6 (5A)/SSTX_P: U42.6 (TXp); also elsewhere on the board
/DN Port 6 (5A)/SW_EN: Q6.3 (D), Q19.3 (D), R81.2, R171.2, U44.4 (EN)
/DN Port 6 (5A)/VBUS_CONN: C153.1, FB7.2, J7.A4 (VBUS), J7.A9 (VBUS), J7.B4 (VBUS), J7.B9 (VBUS), R85.1
/DN Port 6 (5A)/VBUS_DET: R85.2, U42.5 (VBUS_DET)
/DN Port 6 (5A)/VBUS_SW: C156.2, C157.1, C158.1, FB7.1, R88.2, R139.1, U45.8 (Vbus), U45.9 (Vin-)
/I2C0_SCL: U45.1 (A1), U45.2 (A0), U45.5 (SCL); also elsewhere on the board
/I2C0_SDA: U45.4 (SDA); also elsewhere on the board
/MUX_DISABLE: U42.29 (ENn_CC); also elsewhere on the board
/TUSB8044A Hub1/PWRON3_BATEN3: R81.1; also elsewhere on the board
/USB6_INHIBIT: R150.1; also elsewhere on the board
/USBLED_56: R89.2; also elsewhere on the board
GND: C146.2, C147.2, C148.2, C153.2, C154.2, C155.2, C157.2, C158.2, C159.2, J7.A1 (GND), J7.A12 (GND), J7.B1 (GND), J7.B12 (GND), J7.SH (SHIELD), Q6.2 (S), Q19.2 (S), R87.2, R139.2, R151.2, U40.3 (GND), U40.8 (GND), U41.3 (GND), U41.8 (GND), U42.12 (ENn_MUX), U42.13 (GND), U42.28 (GND), U42.31 (PAD), U43.3 (GND), U43.8 (GND), U44.1 (GND), U44.9 (PAD), U45.7 (GND); also elsewhere on the board
unnamed: D7.1 (K), R89.1
unnamed: Q19.1 (G), R150.2, R151.1
unnamed: R87.1, U44.5 (ILIM)

Notes on the sheet:
VBUS FILTER
I2C address is strapped on the root through ADDR_A1 / ADDR_A0.
STRAPS AND PULL-UPS
polarity swap is detected in the receiver
R_ILIM 20K: limit 5.18 A min / 5.54 A typ / 5.80 A max (datasheet eq. 1).
CC CONTROLLER + SS MUX (DFP, GPIO mode)
R102 sets Type-C current advertisement: NOPOP = default, 499K = 1.5A, 10K = 3A
PORT POWER SWITCH (per TUSB8044AEVM)
CUR_MODE 10K fitted = 3 A Type-C advertisement (max without USB-PD).
SS TX AC COUPLING (place at connector)
PORT 6 POWER: R81 DNI; R171 (100k, +3V3 to SW_EN) fitted. Power follows attach detection independently of hub PWRON. USB_INHIBIT remains effective for firmware shutdown. Fit only one of R81/R171; swap population to restore hub power control.
SHIELD TERMINATION
Pi 5 draws >3 A only with PSU_MAX_CURRENT=5000 or usb_max_current_enable=1 set on the Pi.
ESD PROTECTION
USB-C DOWNSTREAM PORT MODULE
PORT CURRENT MONITOR: INA226 across 5 mOhm in VBUS, after the switch.
5 A VARIANT of usbc_dfp (full USB 3 data). TPS2557: 25 mOhm, EN active high, 5 A continuous.
USB_INHIBIT high forces VBUS off. Low / MCU reset permits normal hub and attach control. Place the inhibit FET and gate pulldown near the power switch. Gate resistors: 0402.
VBUS ATTACH GATE

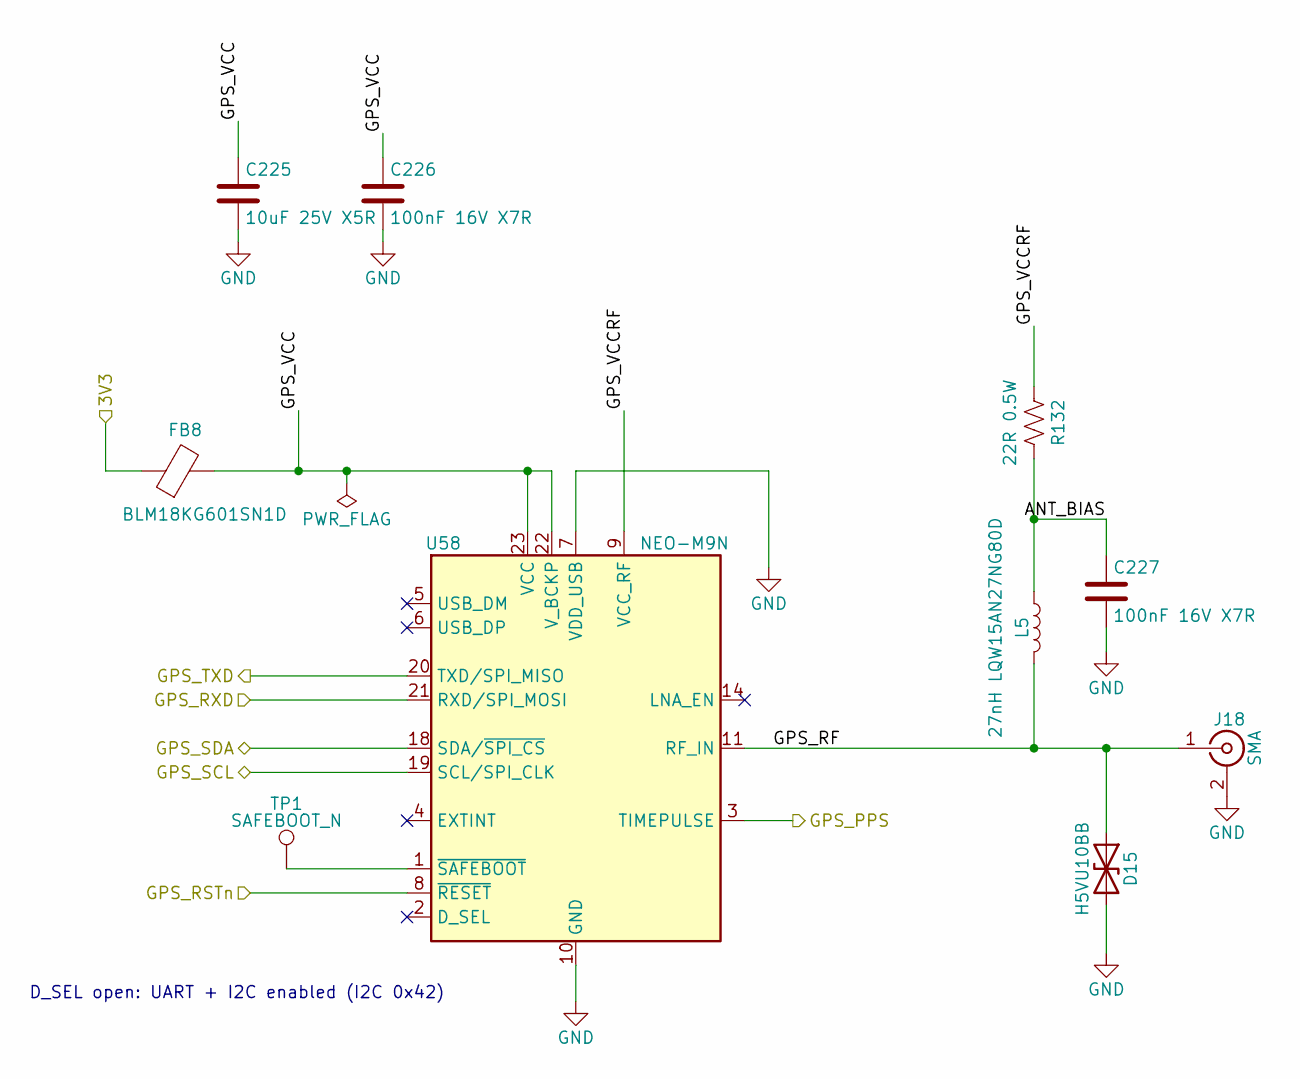
[picture p13: schematic gps.kicad_sch]

Parts:
C225: 10uF 25V X5R; C_0805_2012Metric; LCSC C15850
C226, C227: 100nF 16V X7R; C_0402_1005Metric; LCSC C1525
D15: H5VU10BB; D_0402_1005Metric; LCSC C20615786
FB8: BLM18KG601SN1D; L_0603_1608Metric; LCSC C85833
J18: SMA; SMA_Molex_73251-1153_EdgeMount_Horizontal
L5: 27nH LQW15AN27NG80D; L_0402_1005Metric; LCSC C882469
R132: 22R 0.5W; R_1206_3216Metric; LCSC C2845146
TP1: SAFEBOOT_N; TestPoint_Pad_D1.0mm
U58: NEO-M9N; ublox_NEO; LCSC C5119087

Connections:
+3V3: FB8.1; also elsewhere on the board
/GPS/ANT_BIAS: C227.1, L5.1, R132.2
/GPS/GPS_RF: D15.1 (A1), J18.1 (In), L5.2, U58.11 (RF_IN)
/GPS/GPS_VCC: C225.1, C226.1, FB8.2, U58.22 (V_BCKP), U58.23 (VCC)
/GPS/GPS_VCCRF: R132.1, U58.9 (VCC_RF)
/GPS_PPS: U58.3 (TIMEPULSE); also elsewhere on the board
/GPS_RSTn: U58.8 (~RESET); also elsewhere on the board
/GPS_RXD: U58.21 (RXD/SPI_MOSI); also elsewhere on the board
/GPS_TXD: U58.20 (TXD/SPI_MISO); also elsewhere on the board
/I2C1_SCL: U58.19 (SCL/SPI_CLK); also elsewhere on the board
/I2C1_SDA: U58.18 (SDA/~SPI_CS); also elsewhere on the board
GND: C225.2, C226.2, C227.2, D15.2 (A2), J18.2 (Ext), U58.7 (VDD_USB), U58.10 (GND), U58.12 (GND), U58.13 (GND), U58.24 (GND); also elsewhere on the board
unnamed: TP1.1 (1_1), U58.1 (~SAFEBOOT)

Notes on the sheet:
D_SEL open: UART + I2C enabled (I2C 0x42)
