mikefsq/scope_hub/pcb/scope_hub.kicad_pcb

## KiCad design pcb/scope_hub.kicad_pcb (continued)

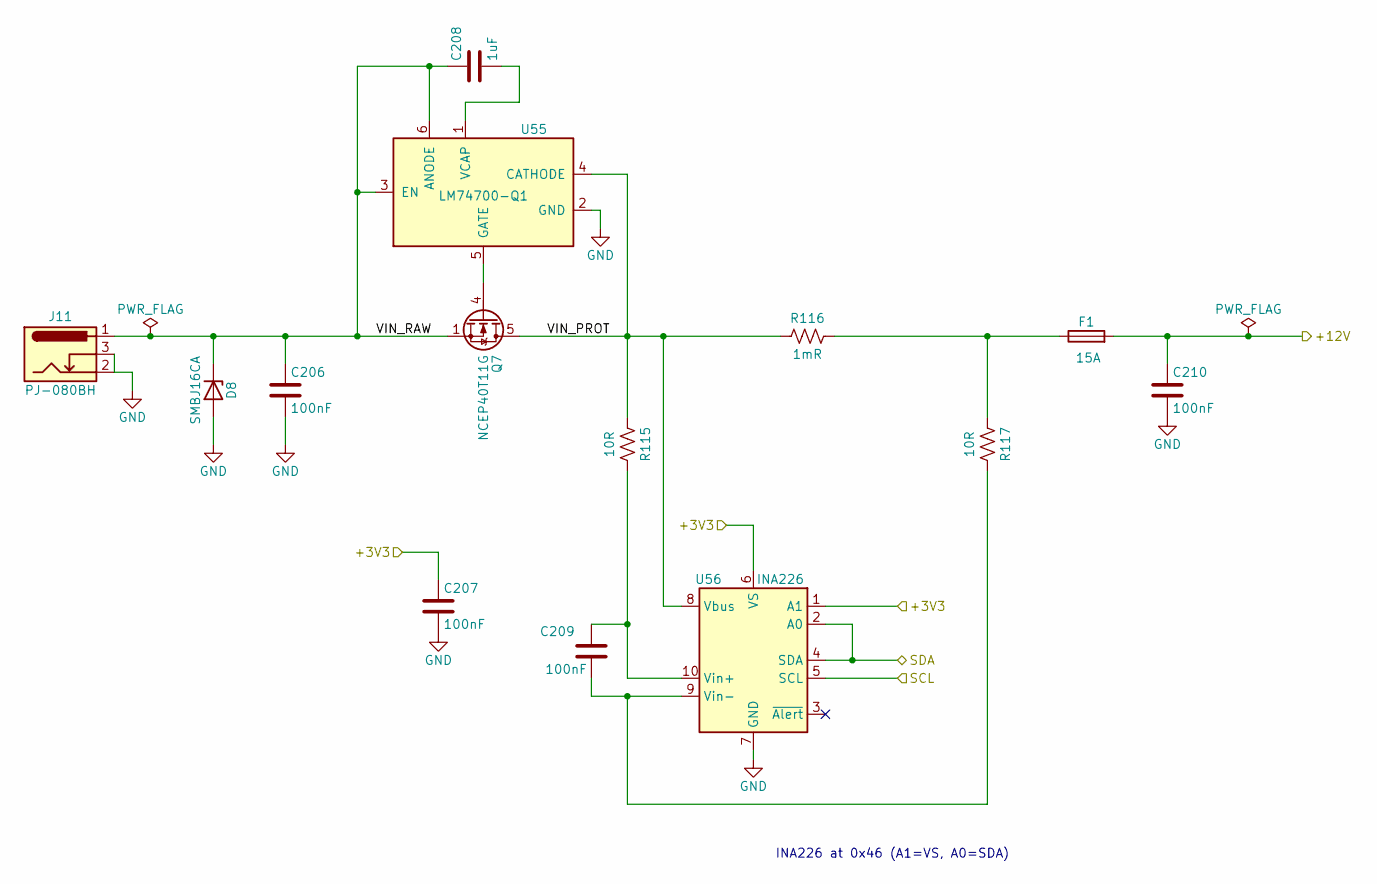
[picture p14: schematic input.kicad_sch]

Parts:
C206, C210: 100nF; C_0603_1608Metric; LCSC C14663
C207, C209: 100nF; C_0402_1005Metric; LCSC C1525
C208: 1uF; C_0603_1608Metric; LCSC C5199872
D8: SMBJ16CA; D_SMB; MPN SMBJ16CA; LCSC C151255
F1: 15A; Fuse_2410_6125Metric_JDT; LCSC C2994767
J11: PJ-080BH; BarrelJack_CUI_PJ-080BH_Horizontal; MPN PJ-080BH; LCSC C3094242
Q7: NCEP40T11G; PowerPAK_SO-8_Single; LCSC C182465
R115, R117: 10R; R_0603_1608Metric; LCSC C22859
R116: 1mR; R_2512_6332Metric; LCSC C5375452
U55: LM74700-Q1; SOT-23-6; MPN LM74700QDBVRQ1; LCSC C2941042
U56: INA226; TSSOP-10_3x3mm_P0.5mm; MPN INA226AIDGSR; LCSC C49851

Connections:
+3V3: C207.1, U56.1 (A1), U56.6 (VS); also elsewhere on the board
+12V: C210.1, F1.2; also elsewhere on the board
/I2C0_SCL: U56.5 (SCL); also elsewhere on the board
/I2C0_SDA: U56.2 (A0), U56.4 (SDA); also elsewhere on the board
/Input 12V/VIN_PROT: Q7.5 (D), R115.1, R116.1, U55.4 (CATHODE), U56.8 (Vbus)
/Input 12V/VIN_RAW: C206.1, C208.1, D8.1 (K), J11.1, Q7.1 (S), Q7.2 (S), Q7.3 (S), U55.3 (EN), U55.6 (ANODE)
GND: C206.2, C207.2, C210.2, D8.2 (A), J11.2, J11.3, U55.2 (GND), U56.7 (GND); also elsewhere on the board
unnamed: F1.1, R116.2, R117.1
unnamed: Q7.4 (G), U55.5 (GATE)
unnamed: C208.2, U55.1 (VCAP)
unnamed: C209.1, R115.2, U56.10 (Vin+)
unnamed: C209.2, R117.2, U56.9 (Vin-)

Notes on the sheet:
INA226 at 0x46 (A1=VS, A0=SDA)

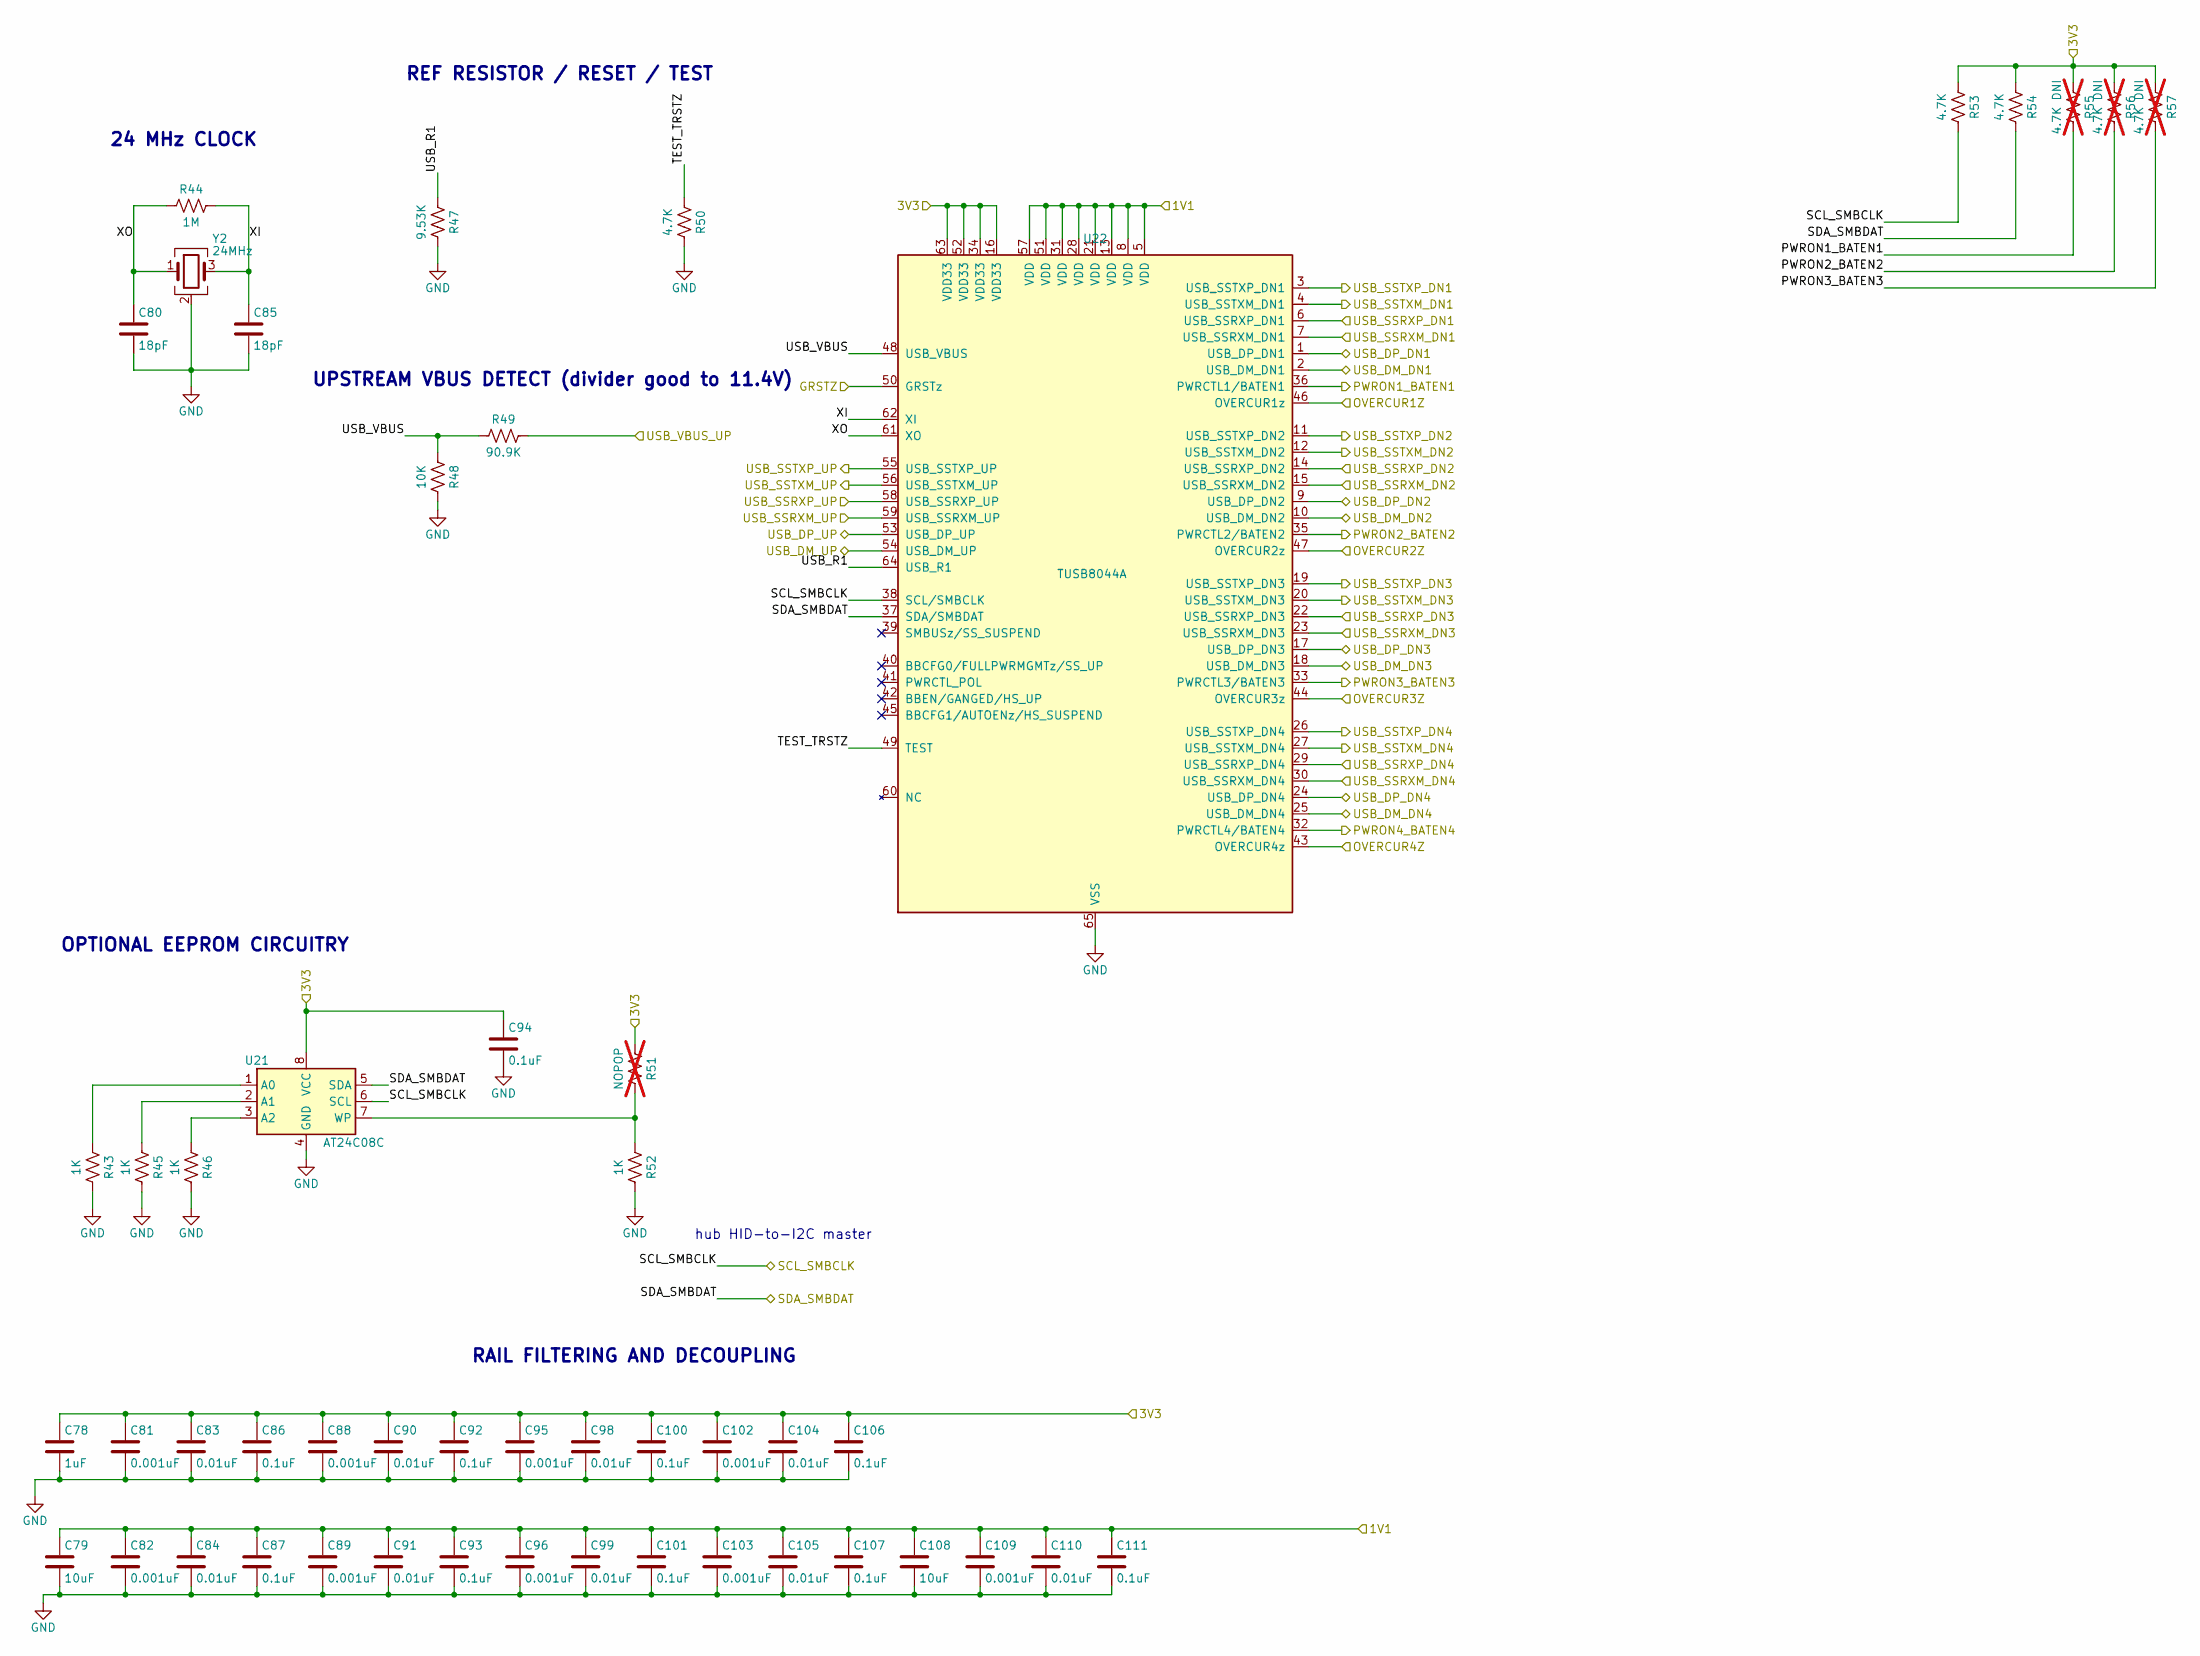
[picture p15: schematic tusb8044a.kicad_sch]

Parts:
C78: 1uF; C_0402_1005Metric; LCSC C52923
C79, C108: 10uF; C_0805_2012Metric; LCSC C15850
C80, C85: 18pF; C_0402_1005Metric; LCSC C1549
C81, C82, C88, C89, C95, C96, C102, C103, C109: 0.001uF; C_0402_1005Metric; LCSC C1523
C83, C84, C90, C91, C98, C99, C104, C105, C110: 0.01uF; C_0402_1005Metric; LCSC C15195
C86, C87, C92, C93, C94, C100, C101, C106, C107, C111: 0.1uF; C_0402_1005Metric; LCSC C1525
R43, R45, R46, R52: 1K; R_0402_1005Metric; LCSC C11702
R44: 1M; R_0402_1005Metric; LCSC C26083
R47: 9.53K; R_0402_1005Metric; LCSC C96273
R48: 10K; R_0402_1005Metric; LCSC C25744
R49: 90.9K; R_0402_1005Metric; LCSC C26989
R50, R53, R54: 4.7K; R_0402_1005Metric; LCSC C25900
R51: NOPOP; R_0402_1005Metric; not fitted
R55, R56, R57: 4.7K DNI; R_0402_1005Metric; LCSC C25900; not fitted
U21: AT24C08C; SOIC-8_3.9x4.9mm_P1.27mm; LCSC C31422
U22: TUSB8044A; QFN-64-1EP_9x9mm_P0.5mm_EP6x6mm_ThermalVias; MPN TUSB8044ARGCR; LCSC C2678041
Y2: 24MHz; Crystal_SMD_3225-4Pin_3.2x2.5mm; LCSC C362340

Connections:
+1V1: C79.1, C82.1, C84.1, C87.1, C89.1, C91.1, C93.1, C96.1, C99.1, C101.1, C103.1, C105.1, C107.1, C108.1, C109.1, C110.1, C111.1, U22.5 (VDD), U22.8 (VDD), U22.13 (VDD), U22.21 (VDD), U22.28 (VDD), U22.31 (VDD), U22.51 (VDD), U22.57 (VDD); also elsewhere on the board
+3V3: C78.1, C81.1, C83.1, C86.1, C88.1, C90.1, C92.1, C94.1, C95.1, C98.1, C100.1, C102.1, C104.1, C106.1, R51.1, R53.1, R54.1, R55.1, R56.1, R57.1, U21.8 (VCC), U22.16 (VDD33), U22.34 (VDD33), U22.52 (VDD33), U22.63 (VDD33); also elsewhere on the board
/DN4_D_N: U22.2 (USB_DM_DN1); also elsewhere on the board
/DN4_D_P: U22.1 (USB_DP_DN1); also elsewhere on the board
/DN5_D_N: U22.10 (USB_DM_DN2); also elsewhere on the board
/DN5_D_P: U22.9 (USB_DP_DN2); also elsewhere on the board
/DN6_D_N: U22.18 (USB_DM_DN3); also elsewhere on the board
/DN6_D_P: U22.17 (USB_DP_DN3); also elsewhere on the board
/DN Port 4/OVERCUR_N: U22.46 (OVERCUR1z); also elsewhere on the board
/DN Port 4/SSRX_N: U22.7 (USB_SSRXM_DN1); also elsewhere on the board
/DN Port 4/SSRX_P: U22.6 (USB_SSRXP_DN1); also elsewhere on the board
/DN Port 4/SSTX_N: U22.4 (USB_SSTXM_DN1); also elsewhere on the board
/DN Port 4/SSTX_P: U22.3 (USB_SSTXP_DN1); also elsewhere on the board
/DN Port 5/OVERCUR_N: U22.47 (OVERCUR2z); also elsewhere on the board
/DN Port 5/SSRX_N: U22.15 (USB_SSRXM_DN2); also elsewhere on the board
/DN Port 5/SSRX_P: U22.14 (USB_SSRXP_DN2); also elsewhere on the board
/DN Port 5/SSTX_N: U22.12 (USB_SSTXM_DN2); also elsewhere on the board
/DN Port 5/SSTX_P: U22.11 (USB_SSTXP_DN2); also elsewhere on the board
/DN Port 6 (5A)/OVERCUR_N: U22.44 (OVERCUR3z); also elsewhere on the board
/DN Port 6 (5A)/SSRX_N: U22.23 (USB_SSRXM_DN3); also elsewhere on the board
/DN Port 6 (5A)/SSRX_P: U22.22 (USB_SSRXP_DN3); also elsewhere on the board
/DN Port 6 (5A)/SSTX_N: U22.20 (USB_SSTXM_DN3); also elsewhere on the board
/DN Port 6 (5A)/SSTX_P: U22.19 (USB_SSTXP_DN3); also elsewhere on the board
/LB_N: U22.59 (USB_SSRXM_UP); also elsewhere on the board
/LB_P: U22.58 (USB_SSRXP_UP); also elsewhere on the board
/LC_N: U22.56 (USB_SSTXM_UP); also elsewhere on the board
/LC_P: U22.55 (USB_SSTXP_UP); also elsewhere on the board
/LNK_D_N: U22.54 (USB_DM_UP); also elsewhere on the board
/LNK_D_P: U22.53 (USB_DP_UP); also elsewhere on the board
/PICO_D_N: U22.25 (USB_DM_DN4); also elsewhere on the board
/PICO_D_P: U22.24 (USB_DP_DN4); also elsewhere on the board
/RAILS_READY: U22.50 (GRSTz); also elsewhere on the board
/TUSB8044A Hub1/OVERCUR4Z: U22.43 (OVERCUR4z)
/TUSB8044A Hub1/PWRON1_BATEN1: R55.2, U22.36 (PWRCTL1/BATEN1); also elsewhere on the board
/TUSB8044A Hub1/PWRON2_BATEN2: R56.2, U22.35 (PWRCTL2/BATEN2); also elsewhere on the board
/TUSB8044A Hub1/PWRON3_BATEN3: R57.2, U22.33 (PWRCTL3/BATEN3); also elsewhere on the board
/TUSB8044A Hub1/PWRON4_BATEN4: U22.32 (PWRCTL4/BATEN4)
/TUSB8044A Hub1/SCL_SMBCLK: R53.2, U21.6 (SCL), U22.38 (SCL/SMBCLK)
/TUSB8044A Hub1/SDA_SMBDAT: R54.2, U21.5 (SDA), U22.37 (SDA/SMBDAT)
/TUSB8044A Hub1/TEST_TRSTZ: R50.1, U22.49 (TEST)
/TUSB8044A Hub1/USB_R1: R47.1, U22.64 (USB_R1)
/TUSB8044A Hub1/USB_SSRXM_DN4: U22.30 (USB_SSRXM_DN4)
/TUSB8044A Hub1/USB_SSRXP_DN4: U22.29 (USB_SSRXP_DN4)
/TUSB8044A Hub1/USB_SSTXM_DN4: U22.27 (USB_SSTXM_DN4)
/TUSB8044A Hub1/USB_SSTXP_DN4: U22.26 (USB_SSTXP_DN4)
/TUSB8044A Hub1/USB_VBUS: R48.1, R49.1, U22.48 (USB_VBUS)
/TUSB8044A Hub1/XI: C85.1, R44.2, U22.62 (XI), Y2.3
/TUSB8044A Hub1/XO: C80.1, R44.1, U22.61 (XO), Y2.1
/UP_VBUS: R49.2; also elsewhere on the board
GND: C78.2, C79.2, C80.2, C81.2, C82.2, C83.2, C84.2, C85.2, C86.2, C87.2, C88.2, C89.2, C90.2, C91.2, C92.2, C93.2, C94.2, C95.2, C96.2, C98.2, C99.2, C100.2, C101.2, C102.2, C103.2, C104.2, C105.2, C106.2, C107.2, C108.2, C109.2, C110.2, C111.2, R43.2, R45.2, R46.2, R47.2, R48.2, R50.2, R52.2, U21.4 (GND), U22.65 (VSS), Y2.2 (G), Y2.4 (G); also elsewhere on the board
unnamed: R43.1, U21.1 (A0)
unnamed: R45.1, U21.2 (A1)
unnamed: R46.1, U21.3 (A2)
unnamed: R51.2, R52.1, U21.7 (WP)

Parts of its further copies:
C5: 1uF; C_0402_1005Metric; LCSC C52923
C6, C35: 10uF; C_0805_2012Metric; LCSC C15850
C7, C12: 18pF; C_0402_1005Metric; LCSC C1549
C8, C9, C15, C16, C22, C23, C29, C30, C36: 0.001uF; C_0402_1005Metric; LCSC C1523
C10, C11, C17, C18, C25, C26, C31, C32, C37: 0.01uF; C_0402_1005Metric; LCSC C15195
C13, C14, C19, C20, C21, C27, C28, C33, C34, C38: 0.1uF; C_0402_1005Metric; LCSC C1525
R1, R3, R4, R10: 1K; R_0402_1005Metric; LCSC C11702
R2: 1M; R_0402_1005Metric; LCSC C26083
R5: 9.53K; R_0402_1005Metric; LCSC C96273
R6: 10K; R_0402_1005Metric; LCSC C25744
R7: 90.9K; R_0402_1005Metric; LCSC C26989
R8, R11, R12: 4.7K; R_0402_1005Metric; LCSC C25900
R9: NOPOP; R_0402_1005Metric; not fitted
R13, R14, R15: 4.7K DNI; R_0402_1005Metric; LCSC C25900; not fitted
U1: AT24C08C; SOIC-8_3.9x4.9mm_P1.27mm; LCSC C31422
U2: TUSB8044A; QFN-64-1EP_9x9mm_P0.5mm_EP6x6mm_ThermalVias; MPN TUSB8044ARGCR; LCSC C2678041
Y1: 24MHz; Crystal_SMD_3225-4Pin_3.2x2.5mm; LCSC C362340

Connections of its further copies:
+1V1: C6.1, C9.1, C11.1, C14.1, C16.1, C18.1, C20.1, C23.1, C26.1, C28.1, C30.1, C32.1, C34.1, C35.1, C36.1, C37.1, C38.1, U2.5 (VDD), U2.8 (VDD), U2.13 (VDD), U2.21 (VDD), U2.28 (VDD), U2.31 (VDD), U2.51 (VDD), U2.57 (VDD); also elsewhere on the board
+3V3: C5.1, C8.1, C10.1, C13.1, C15.1, C17.1, C19.1, C21.1, C22.1, C25.1, C27.1, C29.1, C31.1, C33.1, R9.1, R11.1, R12.1, R13.1, R14.1, R15.1, U1.8 (VCC), U2.16 (VDD33), U2.34 (VDD33), U2.52 (VDD33), U2.63 (VDD33); also elsewhere on the board
/DN1_D_N: U2.2 (USB_DM_DN1); also elsewhere on the board
/DN1_D_P: U2.1 (USB_DP_DN1); also elsewhere on the board
/DN2_D_N: U2.10 (USB_DM_DN2); also elsewhere on the board
/DN2_D_P: U2.9 (USB_DP_DN2); also elsewhere on the board
/DN3_D_N: U2.18 (USB_DM_DN3); also elsewhere on the board
/DN3_D_P: U2.17 (USB_DP_DN3); also elsewhere on the board
/DN Port 1/OVERCUR_N: U2.46 (OVERCUR1z); also elsewhere on the board
/DN Port 1/SSRX_N: U2.7 (USB_SSRXM_DN1); also elsewhere on the board
/DN Port 1/SSRX_P: U2.6 (USB_SSRXP_DN1); also elsewhere on the board
/DN Port 1/SSTX_N: U2.4 (USB_SSTXM_DN1); also elsewhere on the board
/DN Port 1/SSTX_P: U2.3 (USB_SSTXP_DN1); also elsewhere on the board
/DN Port 2/OVERCUR_N: U2.47 (OVERCUR2z); also elsewhere on the board
/DN Port 2/SSRX_N: U2.15 (USB_SSRXM_DN2); also elsewhere on the board
/DN Port 2/SSRX_P: U2.14 (USB_SSRXP_DN2); also elsewhere on the board
/DN Port 2/SSTX_N: U2.12 (USB_SSTXM_DN2); also elsewhere on the board
/DN Port 2/SSTX_P: U2.11 (USB_SSTXP_DN2); also elsewhere on the board
/DN Port 3/OVERCUR_N: U2.44 (OVERCUR3z); also elsewhere on the board
/DN Port 3/SSRX_N: U2.23 (USB_SSRXM_DN3); also elsewhere on the board
/DN Port 3/SSRX_P: U2.22 (USB_SSRXP_DN3); also elsewhere on the board
/DN Port 3/SSTX_N: U2.20 (USB_SSTXM_DN3); also elsewhere on the board
/DN Port 3/SSTX_P: U2.19 (USB_SSTXP_DN3); also elsewhere on the board
/LA_N: U2.27 (USB_SSTXM_DN4); also elsewhere on the board
/LA_P: U2.26 (USB_SSTXP_DN4); also elsewhere on the board
/LD_N: U2.30 (USB_SSRXM_DN4); also elsewhere on the board
/LD_P: U2.29 (USB_SSRXP_DN4); also elsewhere on the board
/LNK_D_N: U2.25 (USB_DM_DN4); also elsewhere on the board
/LNK_D_P: U2.24 (USB_DP_DN4); also elsewhere on the board
/RAILS_READY: U2.50 (GRSTz); also elsewhere on the board
/SCL_SMBCLK: R11.2, U1.6 (SCL), U2.38 (SCL/SMBCLK)
/SDA_SMBDAT: R12.2, U1.5 (SDA), U2.37 (SDA/SMBDAT)
/TUSB8044A Hub/OVERCUR4Z: U2.43 (OVERCUR4z)
/TUSB8044A Hub/PWRON1_BATEN1: R13.2, U2.36 (PWRCTL1/BATEN1); also elsewhere on the board
/TUSB8044A Hub/PWRON2_BATEN2: R14.2, U2.35 (PWRCTL2/BATEN2); also elsewhere on the board
/TUSB8044A Hub/PWRON3_BATEN3: R15.2, U2.33 (PWRCTL3/BATEN3); also elsewhere on the board
/TUSB8044A Hub/PWRON4_BATEN4: U2.32 (PWRCTL4/BATEN4)
/TUSB8044A Hub/TEST_TRSTZ: R8.1, U2.49 (TEST)
/TUSB8044A Hub/USB_R1: R5.1, U2.64 (USB_R1)
/TUSB8044A Hub/USB_VBUS: R6.1, R7.1, U2.48 (USB_VBUS)
/TUSB8044A Hub/XI: C12.1, R2.2, U2.62 (XI), Y1.3
/TUSB8044A Hub/XO: C7.1, R2.1, U2.61 (XO), Y1.1
/UP_D_N: U2.54 (USB_DM_UP); also elsewhere on the board
/UP_D_P: U2.53 (USB_DP_UP); also elsewhere on the board
/UP_SSRX_N: U2.59 (USB_SSRXM_UP); also elsewhere on the board
/UP_SSRX_P: U2.58 (USB_SSRXP_UP); also elsewhere on the board
/UP_SSTX_N: U2.56 (USB_SSTXM_UP); also elsewhere on the board
/UP_SSTX_P: U2.55 (USB_SSTXP_UP); also elsewhere on the board
/UP_VBUS: R7.2; also elsewhere on the board
GND: C5.2, C6.2, C7.2, C8.2, C9.2, C10.2, C11.2, C12.2, C13.2, C14.2, C15.2, C16.2, C17.2, C18.2, C19.2, C20.2, C21.2, C22.2, C23.2, C25.2, C26.2, C27.2, C28.2, C29.2, C30.2, C31.2, C32.2, C33.2, C34.2, C35.2, C36.2, C37.2, C38.2, R1.2, R3.2, R4.2, R5.2, R6.2, R8.2, R10.2, U1.4 (GND), U2.65 (VSS), Y1.2 (G), Y1.4 (G); also elsewhere on the board
unnamed: R1.1, U1.1 (A0)
unnamed: R3.1, U1.2 (A1)
unnamed: R4.1, U1.3 (A2)
unnamed: R9.2, R10.1, U1.7 (WP)

Notes on the sheet:
24 MHz CLOCK
RAIL FILTERING AND DECOUPLING
UPSTREAM VBUS DETECT (divider good to 11.4V)
REF RESISTOR / RESET / TEST
hub HID-to-I2C master
OPTIONAL EEPROM CIRCUITRY

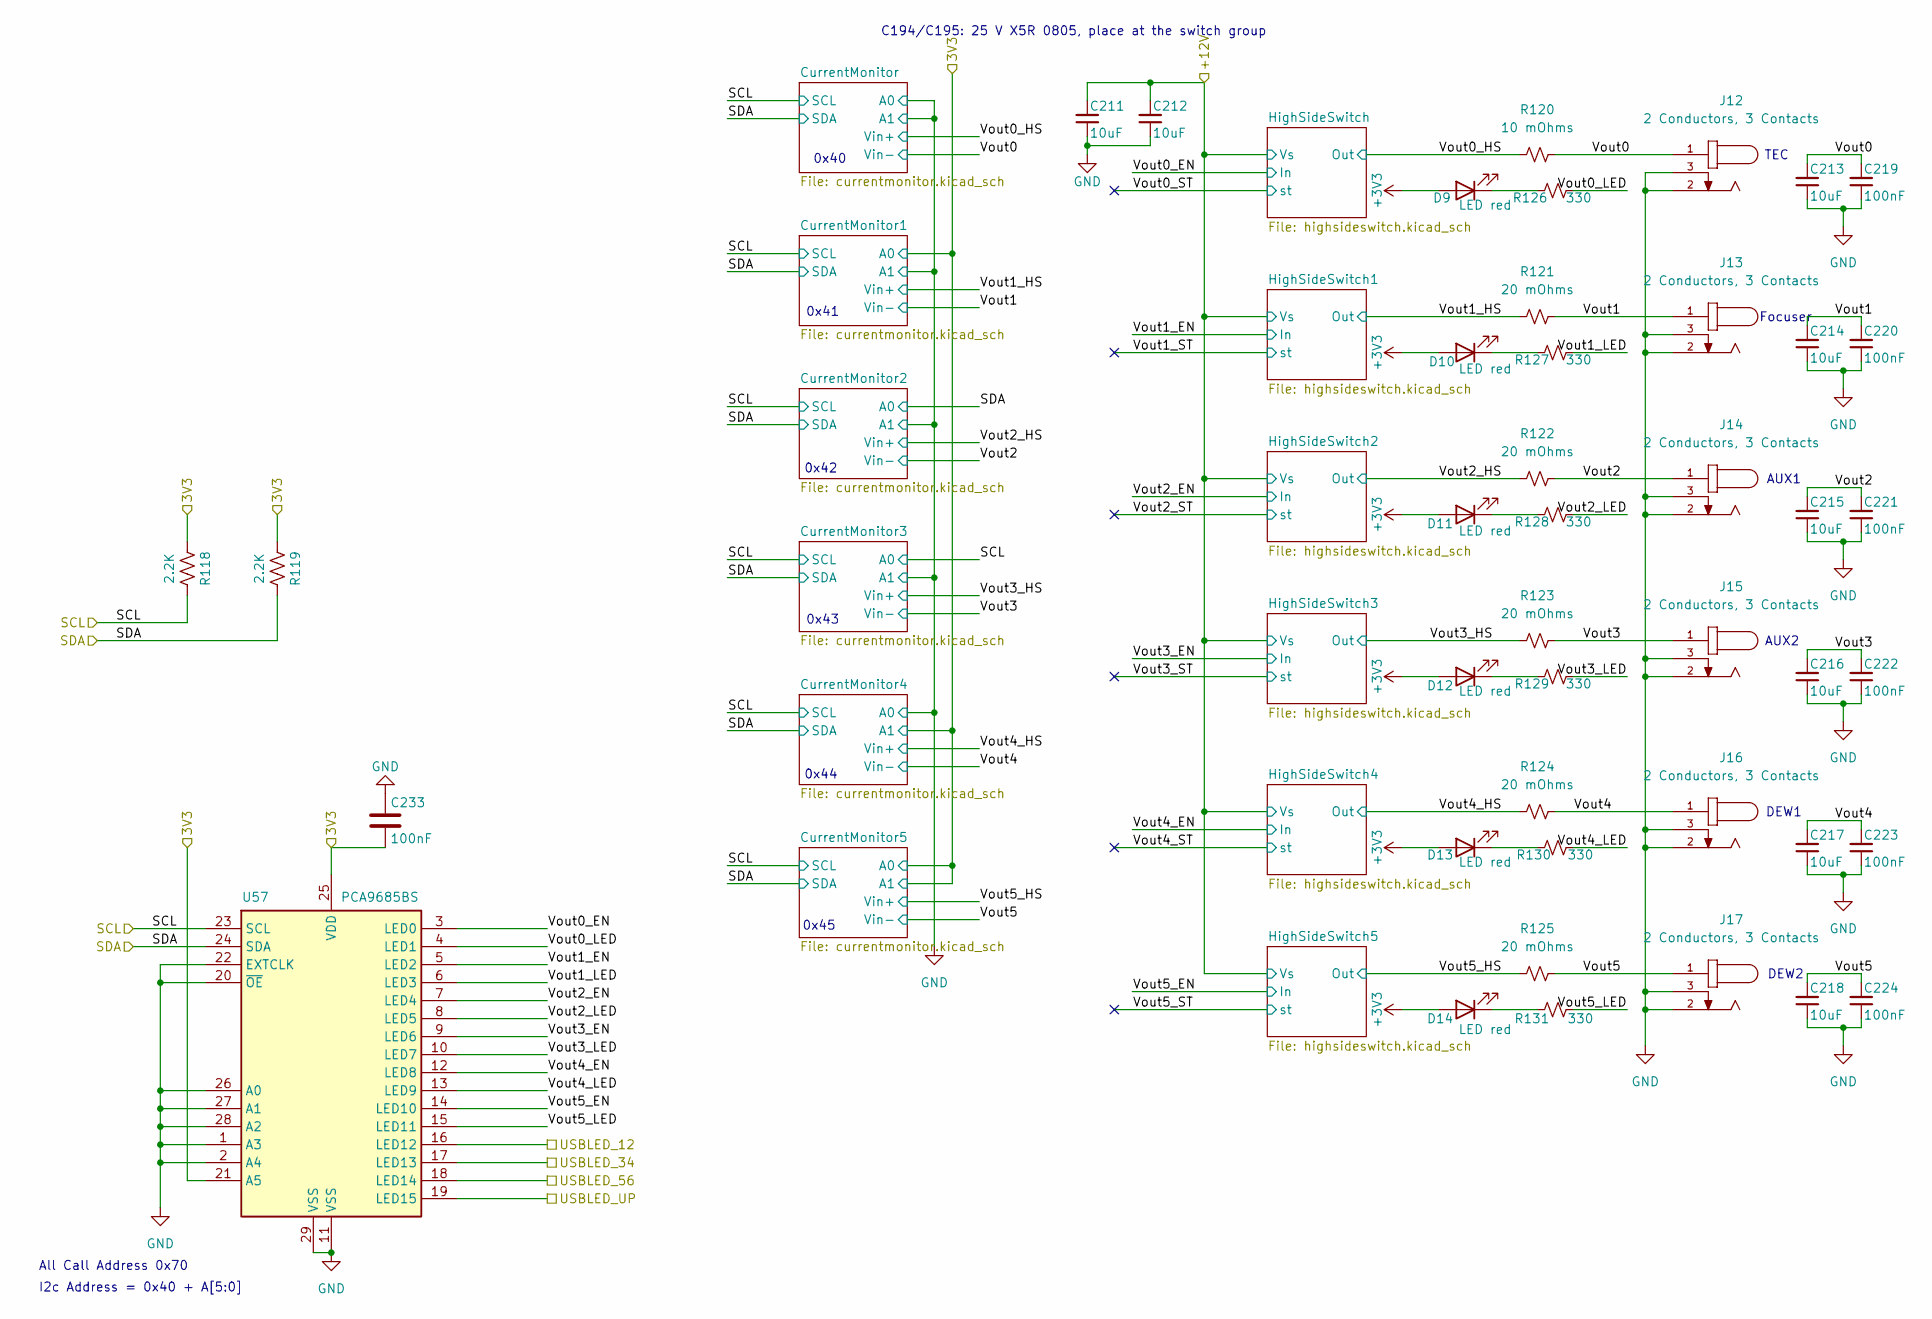
[picture p16: schematic dc_ports.kicad_sch]

Parts:
C211, C212, C213, C214, C215, C216, C217, C218: 10uF; C_1210_3225Metric; LCSC C386166
C219, C220, C221, C222, C223, C224: 100nF; C_0603_1608Metric; LCSC C14663
C233: 100nF; C_0402_1005Metric; LCSC C1525
D9, D10, D11, D12, D13, D14: LED red; LED_0603_1608Metric; LCSC C2286
J12, J13, J14, J15, J16, J17: 2 Conductors, 3 Contacts; BarrelJack_CUI_PJ-063AH_Horizontal; MPN PJ-063AH; LCSC C22434582
R118, R119: 2.2K; R_0402_1005Metric; LCSC C25879
R120: 10 mOhms; RC2010N_VIS; MPN LRAM20DFER010; LCSC C22470460
R121, R122, R123, R124, R125: 20 mOhms; R_1206_3216Metric; MPN FMF06FTHR020-LH; LCSC C371097
R126, R127, R128, R129, R130, R131: 330; R_0402_1005Metric; LCSC C25104
U57: PCA9685BS; QFN-28-1EP_6x6mm_P0.65mm_EP4.25x4.25mm; MPN PCA9685BS,118; LCSC C5191634

Connections:
+3V3: C233.2, D9.2 (A), D10.2 (A), D11.2 (A), D12.2 (A), D13.2 (A), D14.2 (A), R118.1, R119.1, U57.21 (A5), U57.25 (VDD); also elsewhere on the board
+12V: C211.1, C212.1; also elsewhere on the board
/DC Ports/Vout0: C213.1, C219.1, J12.1, R120.2; also elsewhere on the board
/DC Ports/Vout0_EN: U57.3 (LED0); also elsewhere on the board
/DC Ports/Vout0_HS: R120.1; also elsewhere on the board
/DC Ports/Vout0_LED: R126.2, U57.4 (LED1)
/DC Ports/Vout1: C214.1, C220.1, J13.1, R121.2; also elsewhere on the board
/DC Ports/Vout1_EN: U57.5 (LED2); also elsewhere on the board
/DC Ports/Vout1_HS: R121.1; also elsewhere on the board
/DC Ports/Vout1_LED: R127.2, U57.6 (LED3)
/DC Ports/Vout2: C215.1, C221.1, J14.1, R122.2; also elsewhere on the board
/DC Ports/Vout2_EN: U57.7 (LED4); also elsewhere on the board
/DC Ports/Vout2_HS: R122.1; also elsewhere on the board
/DC Ports/Vout2_LED: R128.2, U57.8 (LED5)
/DC Ports/Vout3: C216.1, C222.1, J15.1, R123.2; also elsewhere on the board
/DC Ports/Vout3_EN: U57.9 (LED6); also elsewhere on the board
/DC Ports/Vout3_HS: R123.1; also elsewhere on the board
/DC Ports/Vout3_LED: R129.2, U57.10 (LED7)
/DC Ports/Vout4: C217.1, C223.1, J16.1, R124.2; also elsewhere on the board
/DC Ports/Vout4_EN: U57.12 (LED8); also elsewhere on the board
/DC Ports/Vout4_HS: R124.1; also elsewhere on the board
/DC Ports/Vout4_LED: R130.2, U57.13 (LED9)
/DC Ports/Vout5: C218.1, C224.1, J17.1, R125.2; also elsewhere on the board
/DC Ports/Vout5_EN: U57.14 (LED10); also elsewhere on the board
/DC Ports/Vout5_HS: R125.1; also elsewhere on the board
/DC Ports/Vout5_LED: R131.2, U57.15 (LED11)
/I2C0_SCL: R118.2, U57.23 (SCL); also elsewhere on the board
/I2C0_SDA: R119.2, U57.24 (SDA); also elsewhere on the board
/USBLED_12: U57.16 (LED12); also elsewhere on the board
/USBLED_34: U57.17 (LED13); also elsewhere on the board
/USBLED_56: U57.18 (LED14); also elsewhere on the board
/USBLED_UP: U57.19 (LED15); also elsewhere on the board
GND: C211.2, C212.2, C213.2, C214.2, C215.2, C216.2, C217.2, C218.2, C219.2, C220.2, C221.2, C222.2, C223.2, C224.2, C233.1, J12.2, J12.3, J13.2, J13.3, J14.2, J14.3, J15.2, J15.3, J16.2, J16.3, J17.2, J17.3, U57.1 (A3), U57.2 (A4), U57.11 (VSS), U57.20 (~OE), U57.22 (EXTCLK), U57.26 (A0), U57.27 (A1), U57.28 (A2), U57.29 (VSS); also elsewhere on the board
unnamed: D9.1 (K), R126.1
unnamed: D10.1 (K), R127.1
unnamed: D11.1 (K), R128.1
unnamed: D12.1 (K), R129.1
unnamed: D13.1 (K), R130.1
unnamed: D14.1 (K), R131.1

Notes on the sheet:
AUX2
DEW2
Focuser
DEW1
0x42
TEC
I2c Address = 0x40 + A[5:0]
C194/C195: 25 V X5R 0805, place at the switch group
0x40
0x45
All Call Address 0x70
0x41
0x44
AUX1
0x43

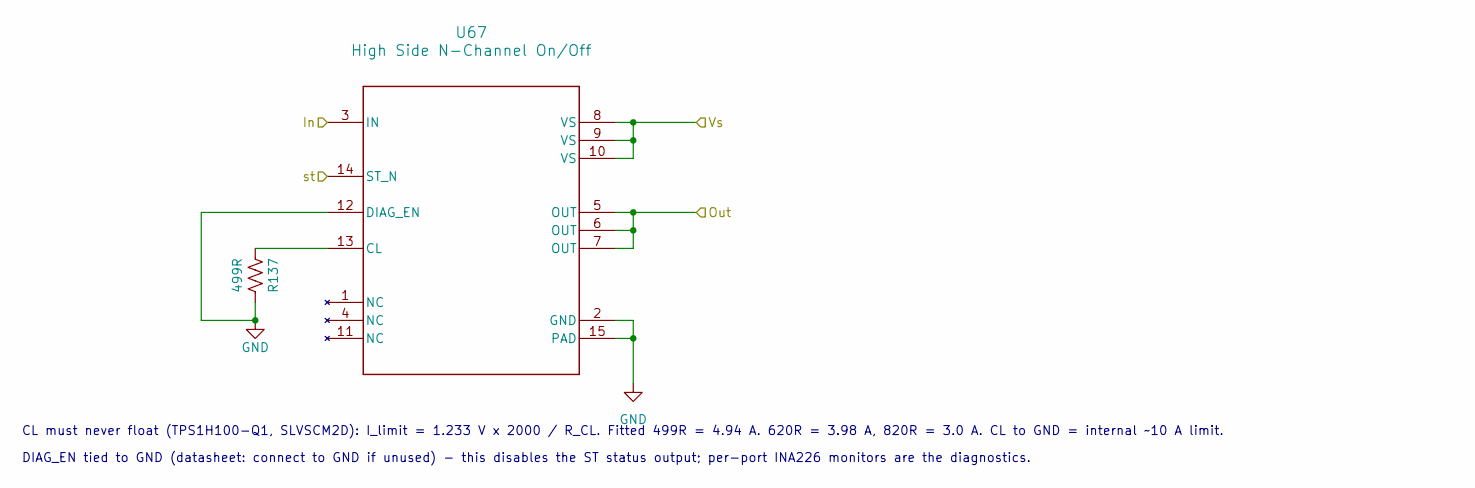
[picture p17: schematic highsideswitch.kicad_sch]

Parts:
R137: 499R; R_0402_1005Metric; LCSC C4125
U67: High Side N-Channel On/Off; PWP0014F_N; MPN TPS1H100AQPWPRQ1; LCSC C478465

Connections:
+12V: U67.8 (VS), U67.9 (VS), U67.10 (VS); also elsewhere on the board
/DC Ports/Vout4_EN: U67.3 (IN); also elsewhere on the board
/DC Ports/Vout4_HS: U67.5 (OUT), U67.6 (OUT), U67.7 (OUT); also elsewhere on the board
/DC Ports/Vout4_ST: U67.14 (ST_N)
GND: R137.2, U67.2 (GND), U67.12 (DIAG_EN), U67.15 (PAD); also elsewhere on the board
unnamed: R137.1, U67.13 (CL)

Parts of its further copies:
R133, R134, R135, R136, R138: 499R; R_0402_1005Metric; LCSC C4125
U63, U64, U65, U66, U68: High Side N-Channel On/Off; PWP0014F_N; MPN TPS1H100AQPWPRQ1; LCSC C478465

Connections of its further copies:
+12V: U63.8 (VS), U63.9 (VS), U63.10 (VS), U64.8 (VS), U64.9 (VS), U64.10 (VS), U65.8 (VS), U65.9 (VS), U65.10 (VS), U66.8 (VS), U66.9 (VS), U66.10 (VS), U68.8 (VS), U68.9 (VS), U68.10 (VS); also elsewhere on the board
/DC Ports/Vout0_EN: U63.3 (IN); also elsewhere on the board
/DC Ports/Vout0_HS: U63.5 (OUT), U63.6 (OUT), U63.7 (OUT); also elsewhere on the board
/DC Ports/Vout0_ST: U63.14 (ST_N)
/DC Ports/Vout1_EN: U64.3 (IN); also elsewhere on the board
/DC Ports/Vout1_HS: U64.5 (OUT), U64.6 (OUT), U64.7 (OUT); also elsewhere on the board
/DC Ports/Vout1_ST: U64.14 (ST_N)
/DC Ports/Vout2_EN: U65.3 (IN); also elsewhere on the board
/DC Ports/Vout2_HS: U65.5 (OUT), U65.6 (OUT), U65.7 (OUT); also elsewhere on the board
/DC Ports/Vout2_ST: U65.14 (ST_N)
/DC Ports/Vout3_EN: U66.3 (IN); also elsewhere on the board
/DC Ports/Vout3_HS: U66.5 (OUT), U66.6 (OUT), U66.7 (OUT); also elsewhere on the board
/DC Ports/Vout3_ST: U66.14 (ST_N)
/DC Ports/Vout5_EN: U68.3 (IN); also elsewhere on the board
/DC Ports/Vout5_HS: U68.5 (OUT), U68.6 (OUT), U68.7 (OUT); also elsewhere on the board
/DC Ports/Vout5_ST: U68.14 (ST_N)
GND: R133.2, R134.2, R135.2, R136.2, R138.2, U63.2 (GND), U63.12 (DIAG_EN), U63.15 (PAD), U64.2 (GND), U64.12 (DIAG_EN), U64.15 (PAD), U65.2 (GND), U65.12 (DIAG_EN), U65.15 (PAD), U66.2 (GND), U66.12 (DIAG_EN), U66.15 (PAD), U68.2 (GND), U68.12 (DIAG_EN), U68.15 (PAD); also elsewhere on the board
unnamed: R133.1, U63.13 (CL)
unnamed: R134.1, U64.13 (CL)
unnamed: R135.1, U65.13 (CL)
unnamed: R136.1, U66.13 (CL)
unnamed: R138.1, U68.13 (CL)

Notes on the sheet:
DIAG_EN tied to GND (datasheet: connect to GND if unused) - this disables the ST status output; per-port INA226 monitors are the diagnostics.
CL must never float (TPS1H100-Q1, SLVSCM2D): I_limit = 1.233 V x 2000 / R_CL. Fitted 499R = 4.94 A. 620R = 3.98 A, 820R = 3.0 A. CL to GND = internal ~10 A limit.

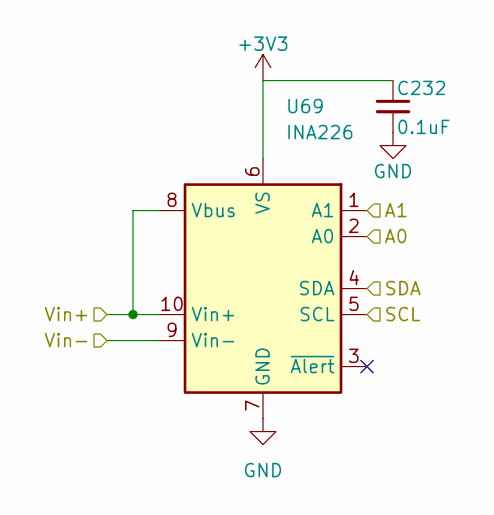
[picture p18: schematic currentmonitor.kicad_sch]

Parts:
C232: 0.1uF; C_0402_1005Metric; LCSC C1525
U69: INA226; TSSOP-10_3x3mm_P0.5mm; MPN INA226AIDGSR; LCSC C49851

Connections:
+3V3: C232.1, U69.2 (A0), U69.6 (VS); also elsewhere on the board
/DC Ports/Vout1: U69.9 (Vin-); also elsewhere on the board
/DC Ports/Vout1_HS: U69.8 (Vbus), U69.10 (Vin+); also elsewhere on the board
/I2C0_SCL: U69.5 (SCL); also elsewhere on the board
/I2C0_SDA: U69.4 (SDA); also elsewhere on the board
GND: C232.2, U69.1 (A1), U69.7 (GND); also elsewhere on the board

Parts of its further copies:
C119, C228, C229, C230, C231: 0.1uF; C_0402_1005Metric; LCSC C1525
U27, U59, U60, U61, U62: INA226; TSSOP-10_3x3mm_P0.5mm; MPN INA226AIDGSR; LCSC C49851

Connections of its further copies:
+3V3: C119.1, C228.1, C229.1, C230.1, C231.1, U27.6 (VS), U59.6 (VS), U60.6 (VS), U61.1 (A1), U61.6 (VS), U62.1 (A1), U62.2 (A0), U62.6 (VS); also elsewhere on the board
/DC Ports/Vout0: U27.9 (Vin-); also elsewhere on the board
/DC Ports/Vout0_HS: U27.8 (Vbus), U27.10 (Vin+); also elsewhere on the board
/DC Ports/Vout2: U59.9 (Vin-); also elsewhere on the board
/DC Ports/Vout2_HS: U59.8 (Vbus), U59.10 (Vin+); also elsewhere on the board
/DC Ports/Vout3: U60.9 (Vin-); also elsewhere on the board
/DC Ports/Vout3_HS: U60.8 (Vbus), U60.10 (Vin+); also elsewhere on the board
/DC Ports/Vout4: U61.9 (Vin-); also elsewhere on the board
/DC Ports/Vout4_HS: U61.8 (Vbus), U61.10 (Vin+); also elsewhere on the board
/DC Ports/Vout5: U62.9 (Vin-); also elsewhere on the board
/DC Ports/Vout5_HS: U62.8 (Vbus), U62.10 (Vin+); also elsewhere on the board
/I2C0_SCL: U27.5 (SCL), U59.5 (SCL), U60.2 (A0), U60.5 (SCL), U61.5 (SCL), U62.5 (SCL); also elsewhere on the board
/I2C0_SDA: U27.4 (SDA), U59.2 (A0), U59.4 (SDA), U60.4 (SDA), U61.4 (SDA), U62.4 (SDA); also elsewhere on the board
GND: C119.2, C228.2, C229.2, C230.2, C231.2, U27.1 (A1), U27.2 (A0), U27.7 (GND), U59.1 (A1), U59.7 (GND), U60.1 (A1), U60.7 (GND), U61.2 (A0), U61.7 (GND), U62.7 (GND); also elsewhere on the board

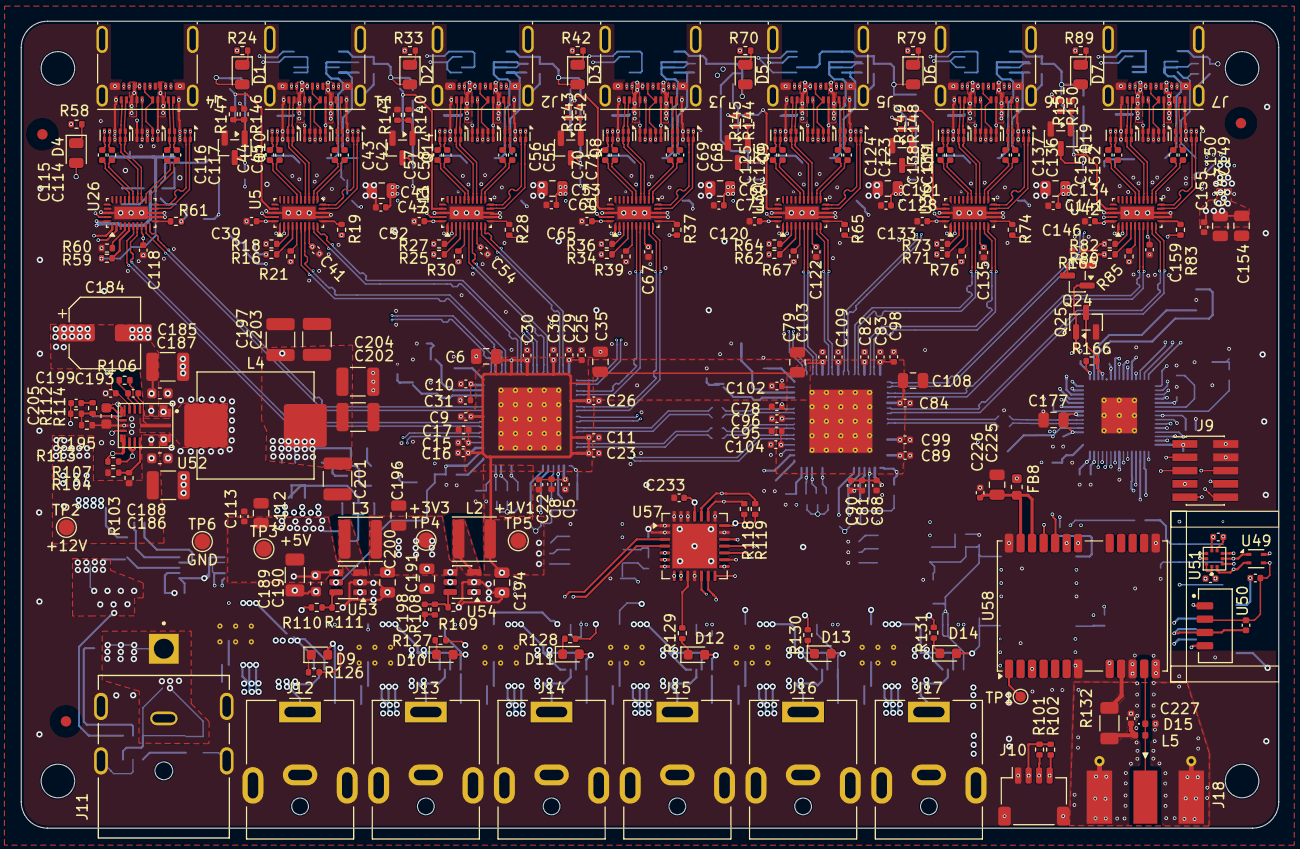
[picture p19: board scope_hub.kicad_pcb from above]

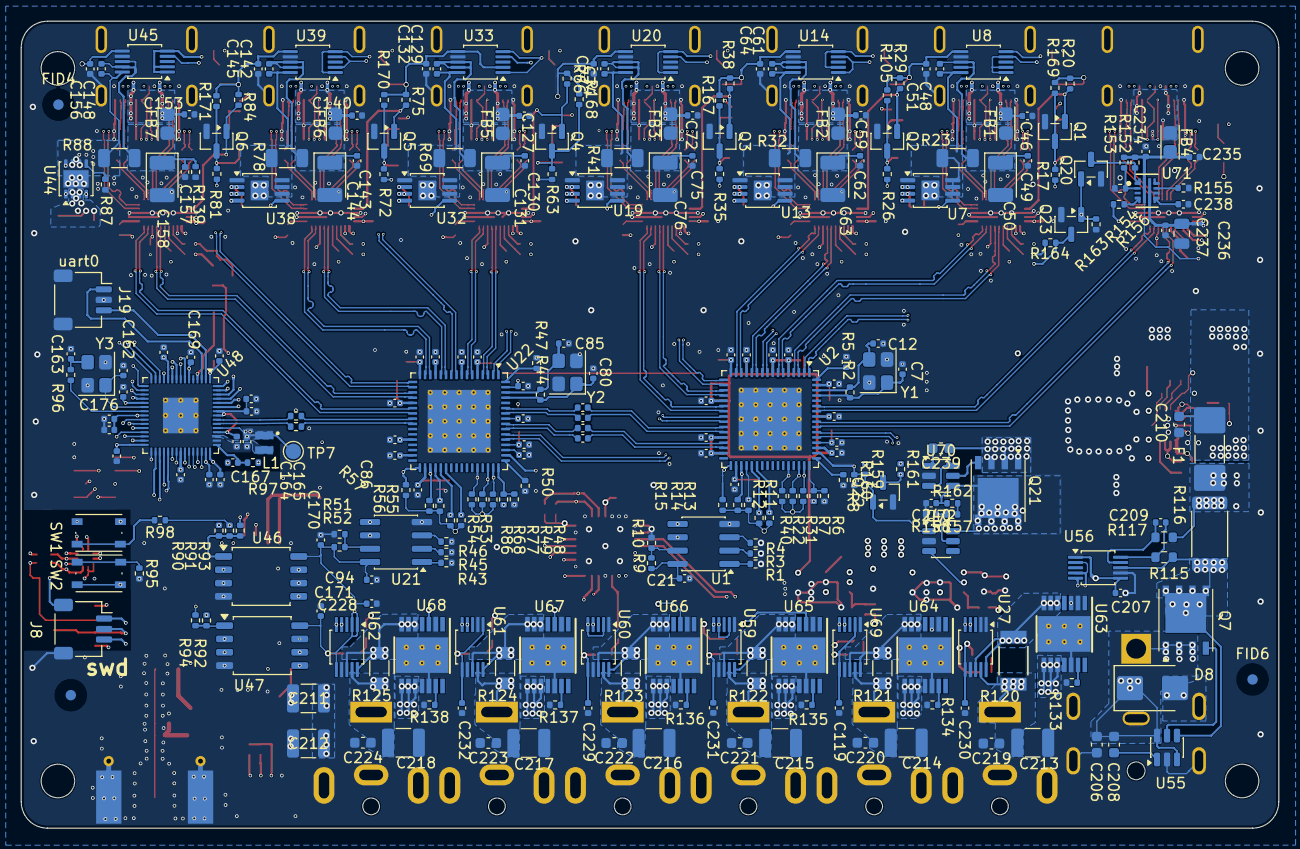
[picture p20: board scope_hub.kicad_pcb from below]

Board: 10 copper layers, 120.0 x 77.0 mm, 569 parts (284 on the bottom side), 387 nets.
