mikefsq/scope_hub/(commit log)

2026-10-31 add driver
2026-10-31 add pcb
    [currentmonitor.kicad_sch, dc_ports.kicad_sch, gps.kicad_sch, highsideswitch.kicad_sch, input.kicad_sch, power.kicad_sch, psu.kicad_sch, regulators.kicad_sch]
2026-11-01 add enclosure
    [ap_los_spacer_11mm.step, bottom_cover.step, primaluce_los_spacer_11mm.step, top_cover.step]
2026-11-07 update cover
    [bottom_cover.step]
